X-Microsystems/xmicro-vdp/README.md

# XMICRO-VDP
Video card for the [XMICRO Bus](https://github.com/X-Microsystems/xmicro-bus), based on the Yamaha V9958 VDP

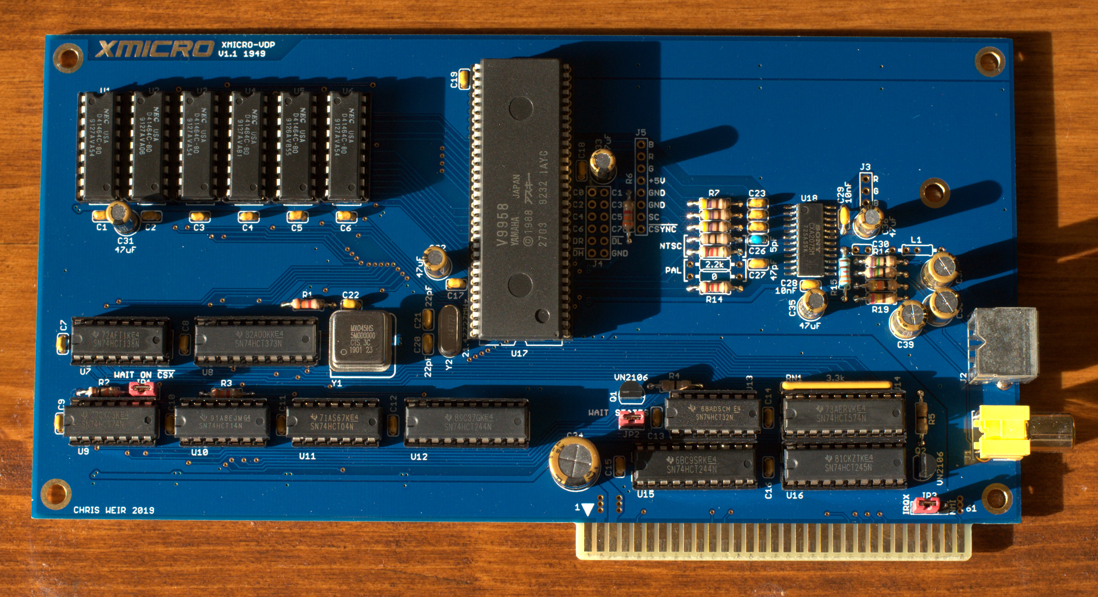
[picture p1: Images/XMICRO-VDP.jpg]
XMICRO-VDP


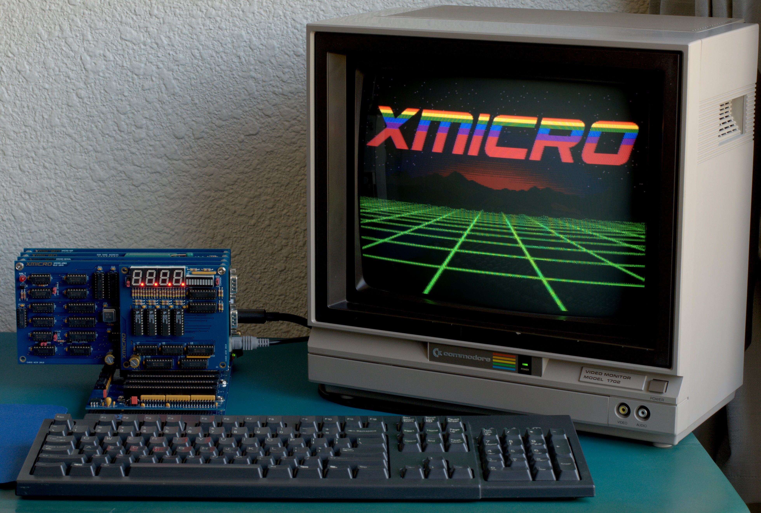
[picture p2: Images/System Running.jpg]
