X-Microsystems/xmicro-vdp/Documentation/Schematics/XMICRO-VDP V1.1 Netlist.txt

Netlist

Exported from XMICRO-VDP V1.1.sch at 12/8/2019 7:52:22 PM

EAGLE Version 6.3.0 Copyright (c) 1988-2012 CadSoft

Net      Part     Pad      Pin        Sheet

!BCSX    CE1      9        !CSX       1
         U15      2        A1         1

!BRD     CE1      21       !RD        1
         U15      15       A3         1

!BRST    CE1      14       !RST       1
         U10      1        I          1

!BWAIT   CE1      18       !WAIT      1
         JP2      2        2          4

!BWR     CE1      22       !WR        1
         U15      6        A3         1

!CSIDR   U12      1        G          5
         U12      19       G          5
         U7       9        Y6         2

!CSVR    U17      31       !CSR       2
         U7       13       Y2         2

!CSVW    U17      30       !CSW       2
         U7       14       Y1         2

!CSX     U11      11       I          4
         U13      13       I1         1
         U13      9        I0         1
         U15      18       Y1         1
         U7       4        G2A        2
         U8       11       ENC        2

!CSYNC   J5       8        8          3
         R14      1        1          3
         U17      6        !CSYNC     2

!DHCLK   J4       11       11         2
         U17      2        !DHCLK     2

!DLCLK   J4       10       10         2
         R6       1        1          2
         U17      3        !DLCLK     2

!RD      U13      12       I0         1
         U15      5        Y3         1
         U7       1        A          2

!RST     U10      4        O          1
         U17      9        !RESET     2
         U9       13       CLR        4

!VCAS0   U1       16       !CAS       2
         U17      61       !CAS0      2
         U4       16       !CAS       2

!VCAS1   U17      60       !CAS1      2
         U2       16       !CAS       2
         U5       16       !CAS       2

!VCAS2   U17      59       !CASX      2
         U3       16       !CAS       2
         U6       16       !CAS       2

!VINT    R1       1        1          1
         U10      9        I          1
         U17      25       !INT       2

!VRAS    U1       5        !RAS       2
         U17      62       !RAS       2
         U2       5        !RAS       2
         U3       5        !RAS       2
         U4       5        !RAS       2
         U5       5        !RAS       2
         U6       5        !RAS       2

!VWAIT   R3       1        1          4
         U10      13       I          4
         U17      26       !WAIT      2

!WR      U11      1        I          1
         U13      10       I1         1
         U15      14       Y3         1
         U7       2        B          2

A0       U15      7        Y2         1
         U8       3        1D         2

A1       U15      12       Y4         1
         U8       4        2D         2

A7       U15      9        Y1         1
         U7       3        C          2
         U8       7        3D         2

B        C25      P$1      1          3
         J5       1        1          3
         R9       2        2          3
         U17      24       B          2

BA0      CE1      23       A0         1
         U15      13       A2         1

BA1      CE1      24       A1         1
         U15      8        A4         1

BA7      CE1      30       A7         1
         U15      11       A1         1

C0       J4       1        1          2
         U17      19       C0         2

C1       J4       2        2          2
         U17      18       C1         2

C2       J4       3        3          2
         U17      17       C2         2

C3       J4       4        4          2
         U17      16       C3         2

C4       J4       5        5          2
         U17      15       C4         2

C5       J4       6        6          2
         U17      14       C5         2

C6       J4       7        7          2
         U17      13       C6         2

C7       J4       8        8          2
         U17      12       C7         2

CBDR     J4       9        9          2
         U17      11       CBDR       2

D0       RN1      2        2          1
         U12      18       Y1         5
         U14      19       1Q         1
         U16      18       B1         1
         U17      40       CD0        2

D1       RN1      3        3          1
         U12      3        Y4         5
         U14      18       2Q         1
         U16      17       B2         1
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

VR/!W    U1       4        !WE        2
         U17      57       R/!W       2
         U2       4        !WE        2
         U3       4        !WE        2
         U4       4        !WE        2
         U5       4        !WE        2
         U6       4        !WE        2
