X-Microsystems/xmicro-vdp/Documentation/Schematics/XMICRO-VDP V1.1 Black Large.pdf

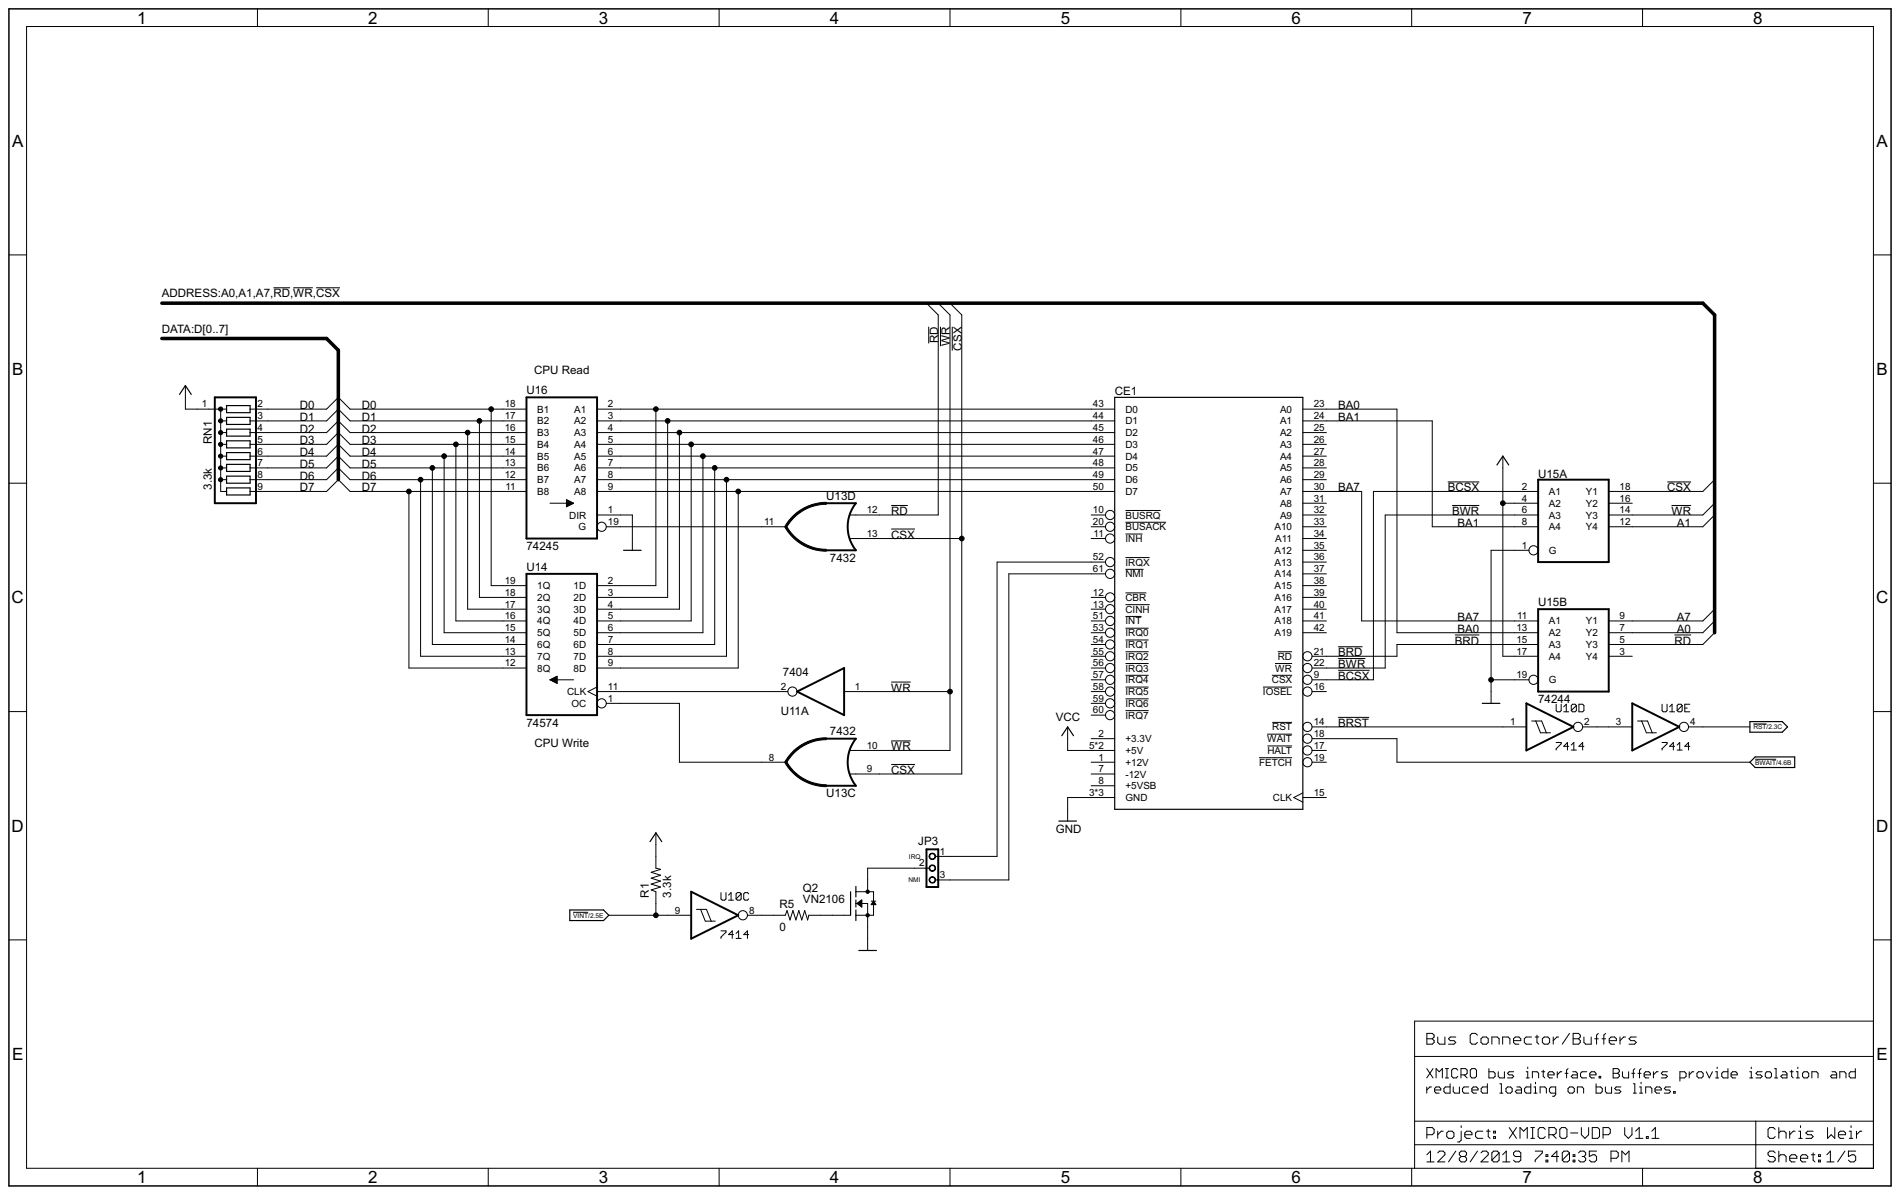
[picture p3: page 1]

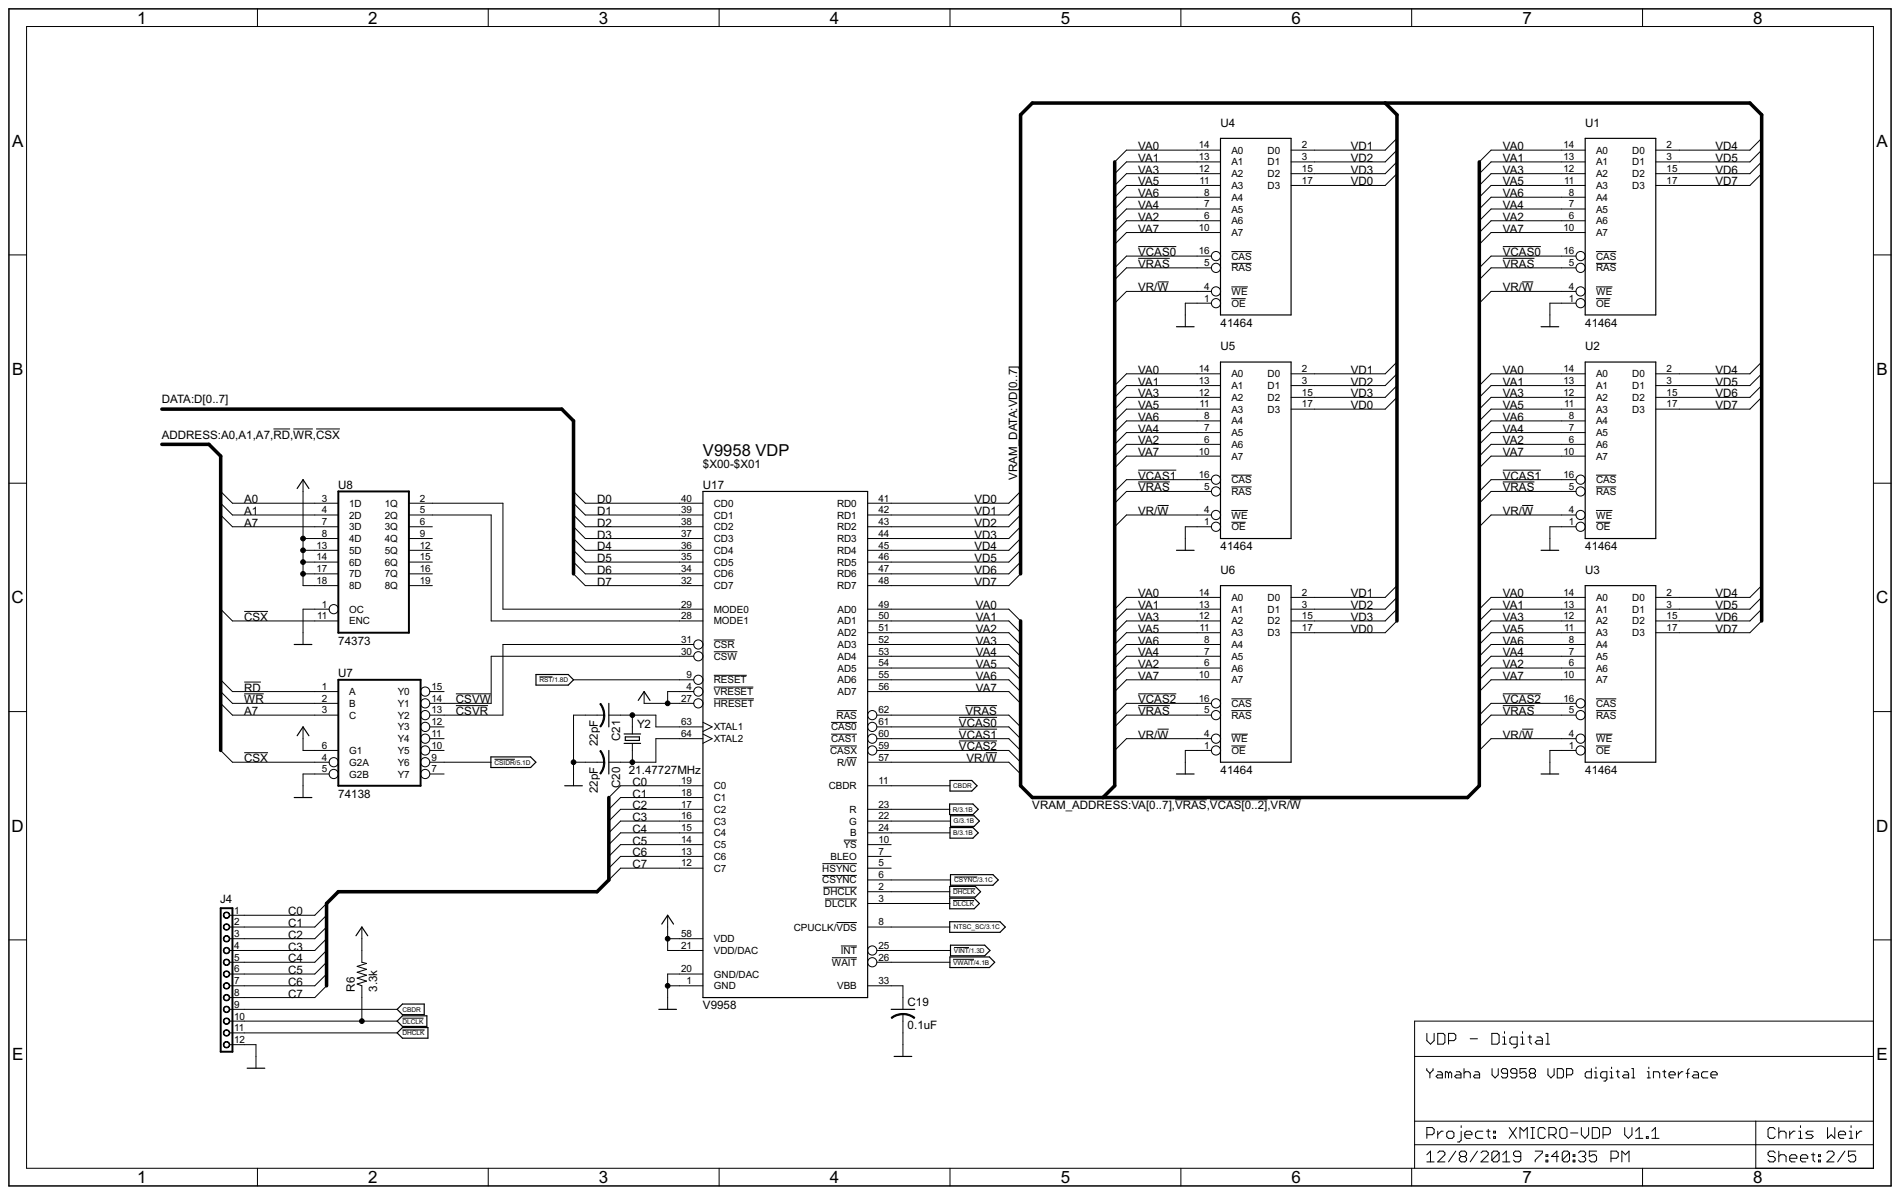
[picture p4: page 2]
