X-Microsystems/xmicro-vdp/Documentation/Schematics/XMICRO-VDP V1.1 Color Large.pdf

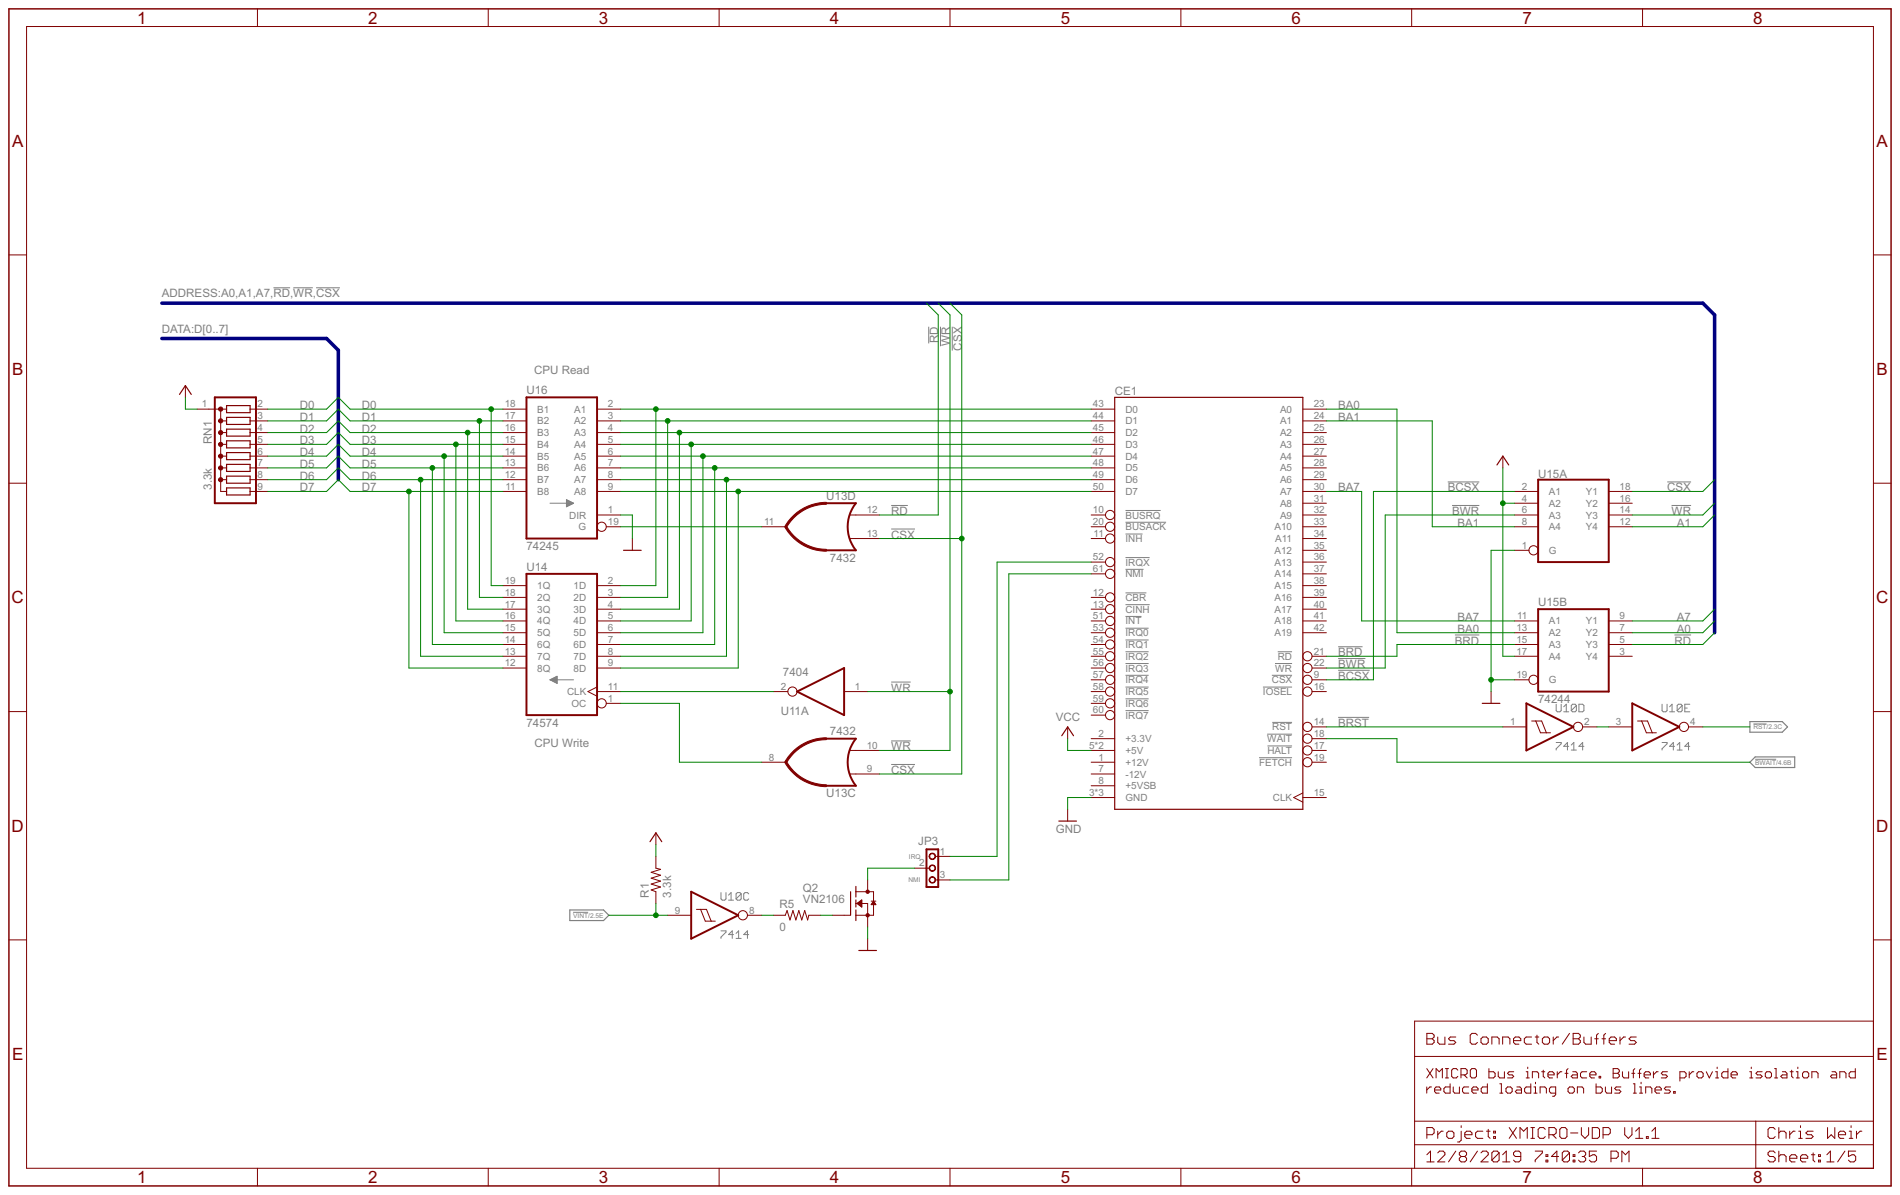
[picture p10: page 1]

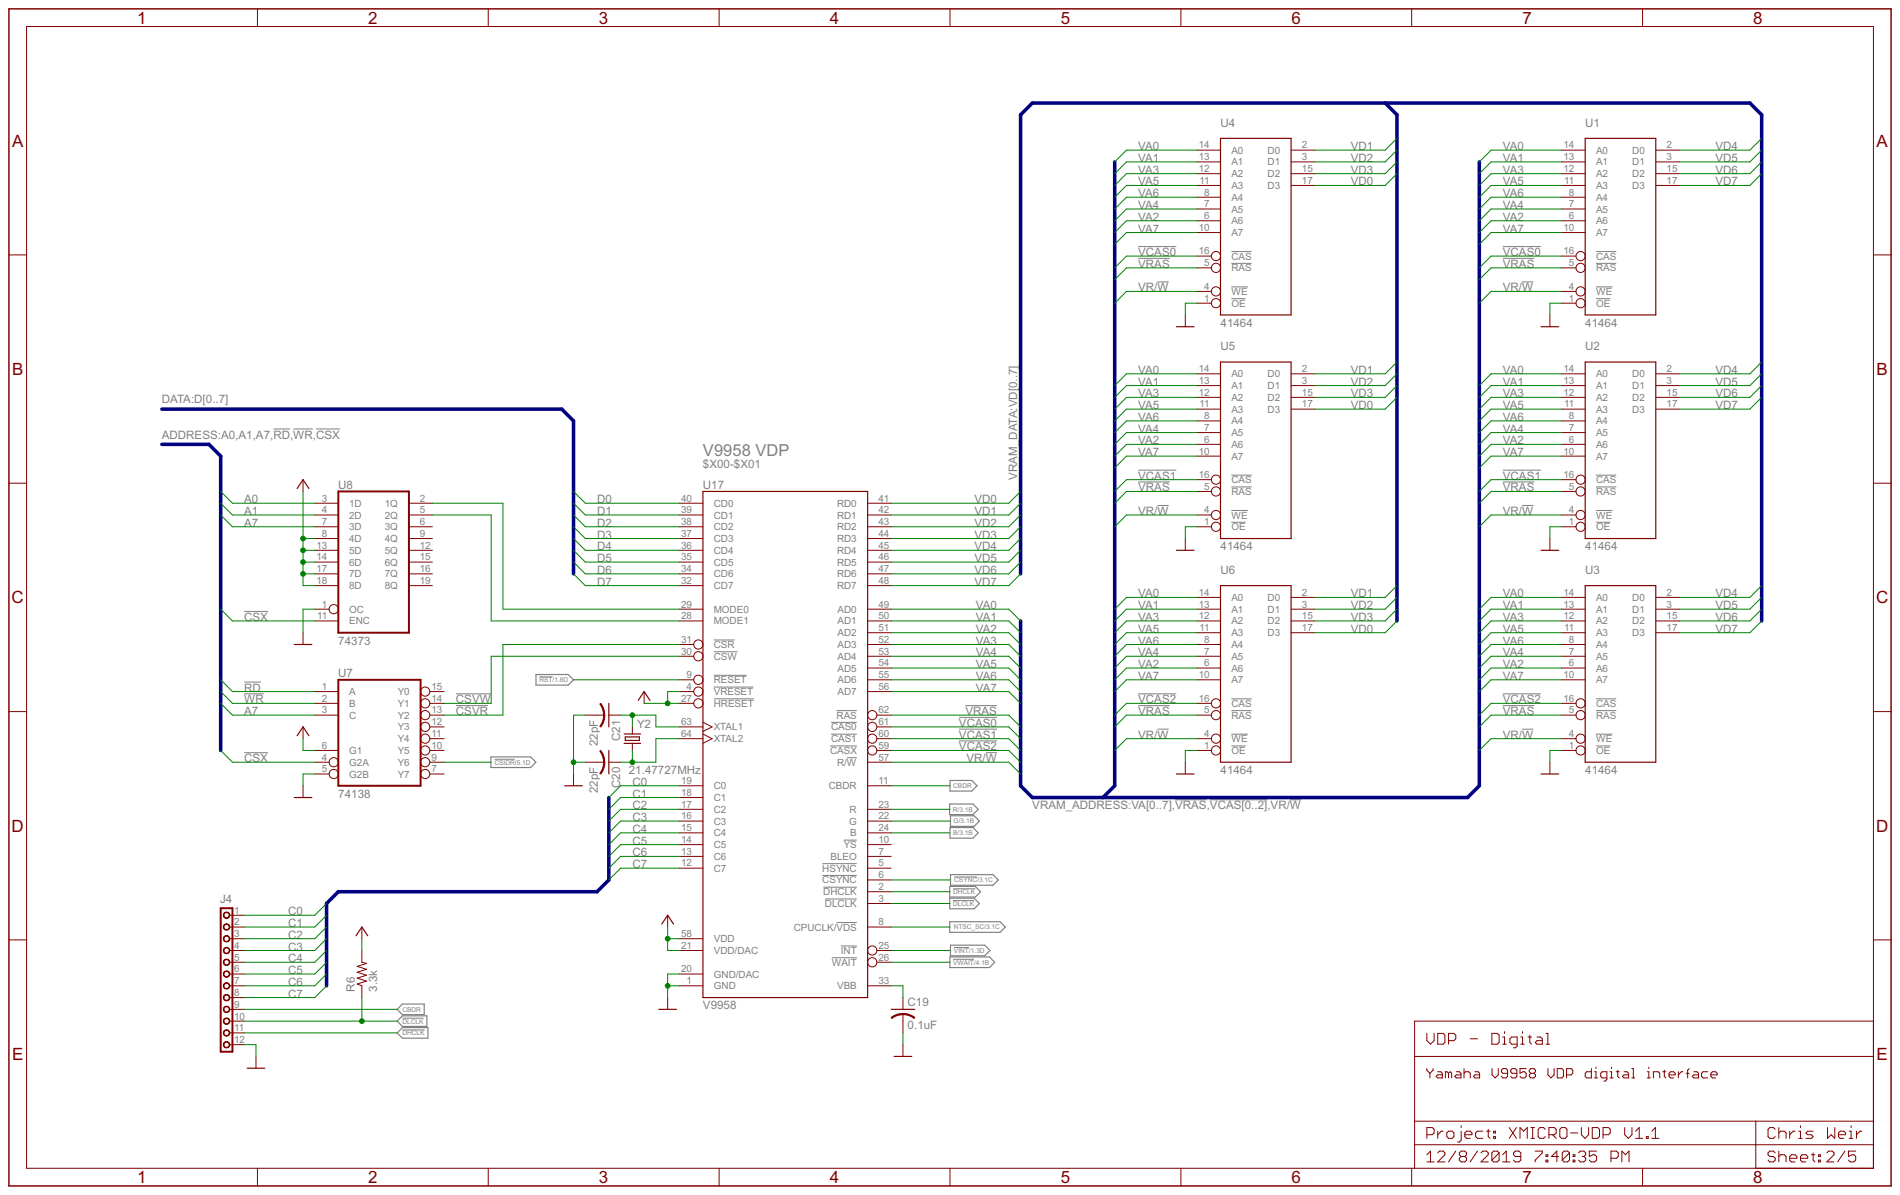
[picture p11: page 2]
