X-Microsystems/xmicro-vdp/Documentation/Schematics/XMICRO-VDP V1.1 Color.pdf

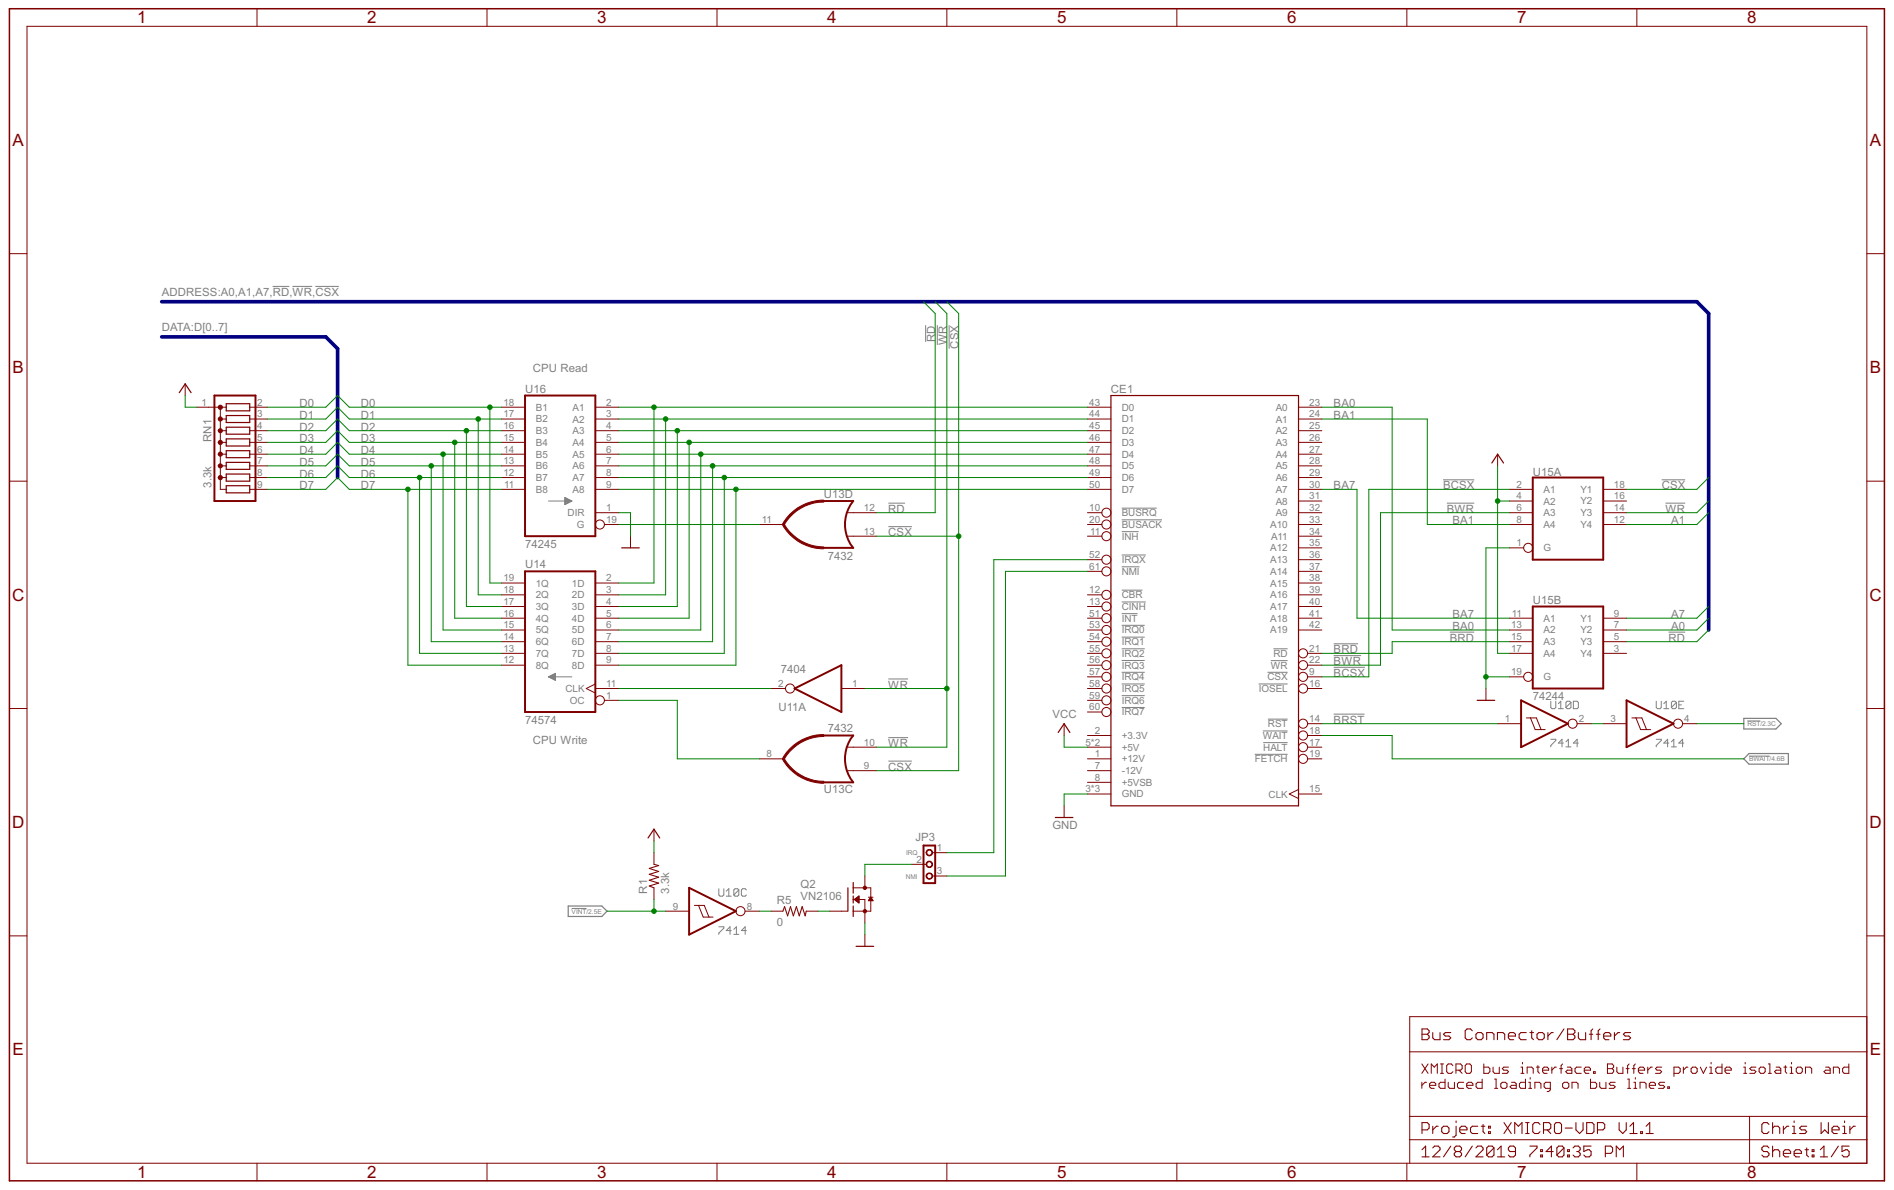
[picture p12: page 1]

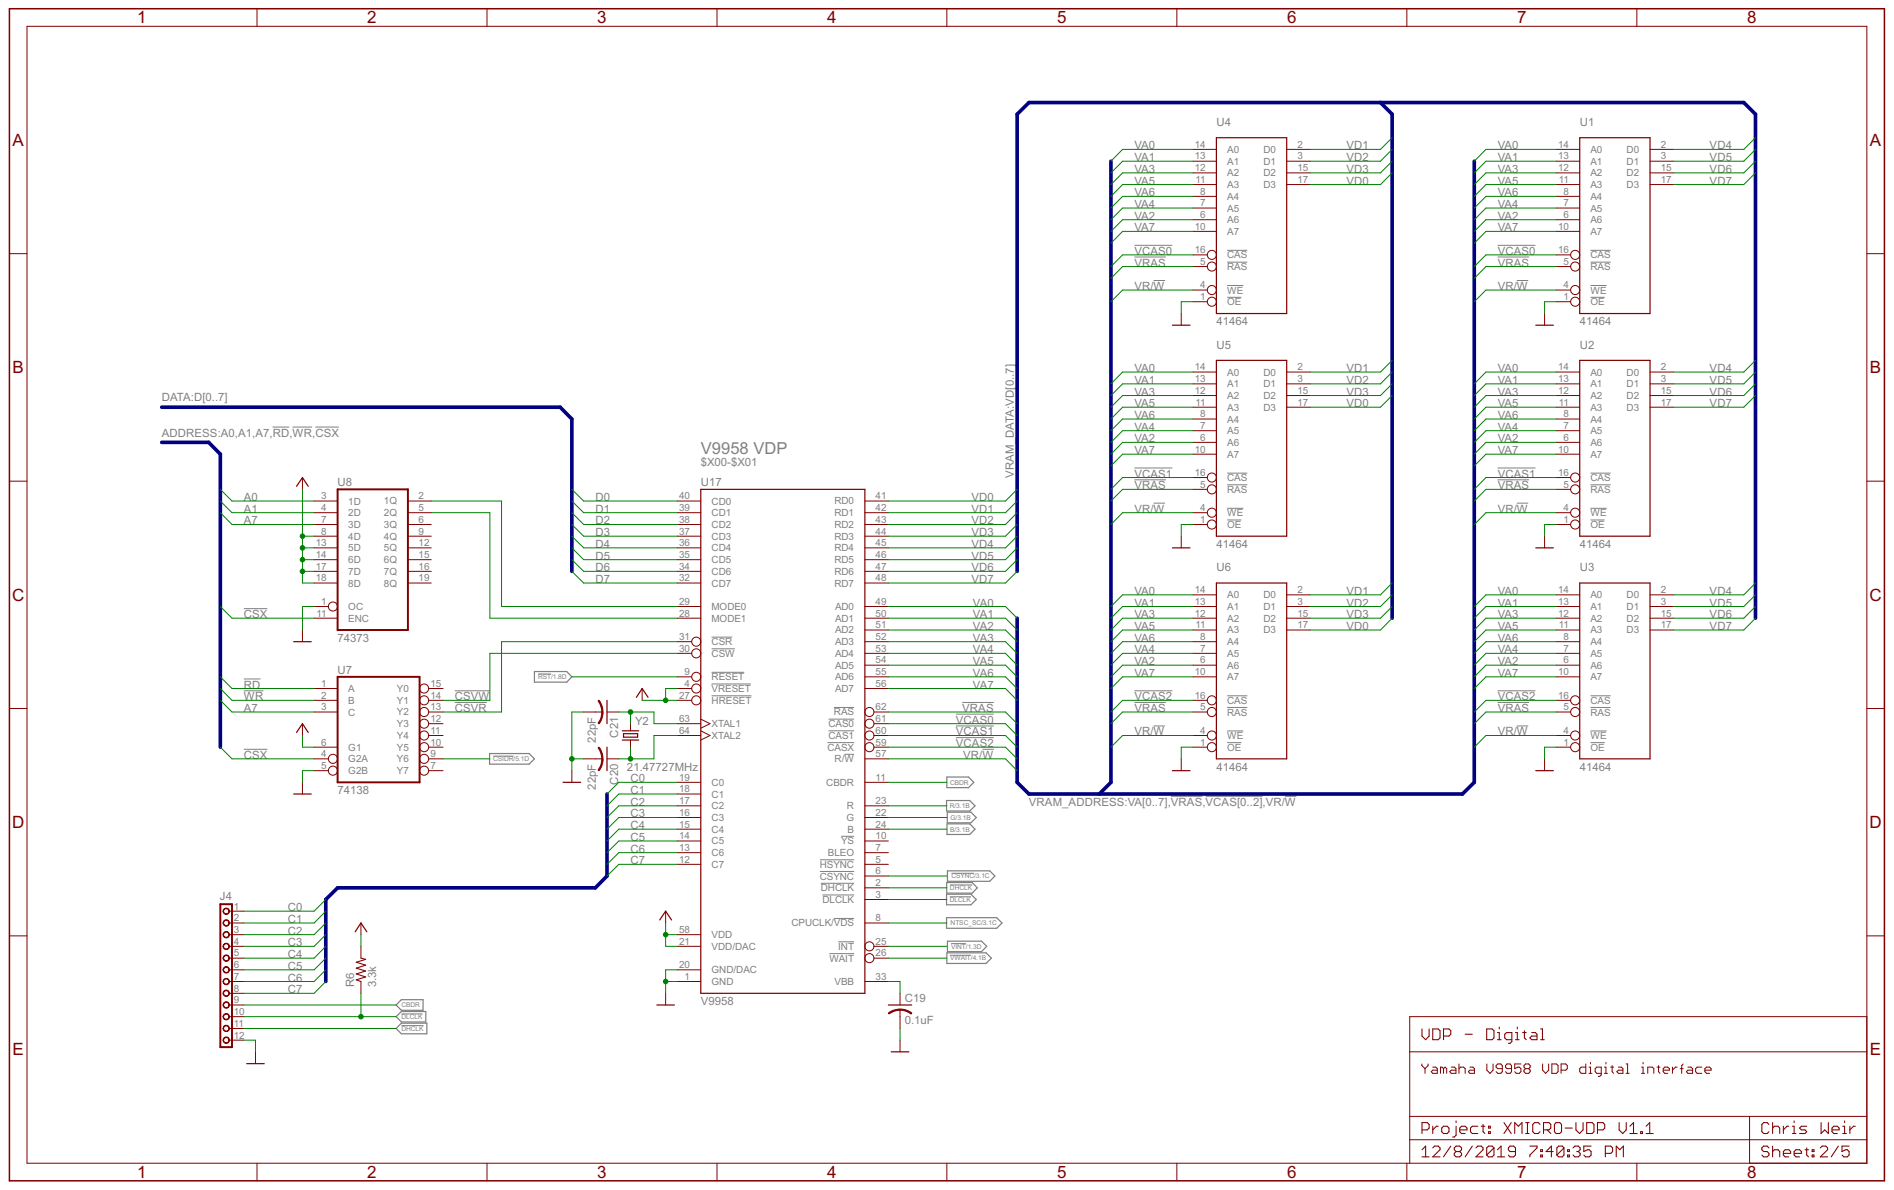
[picture p13: page 2]

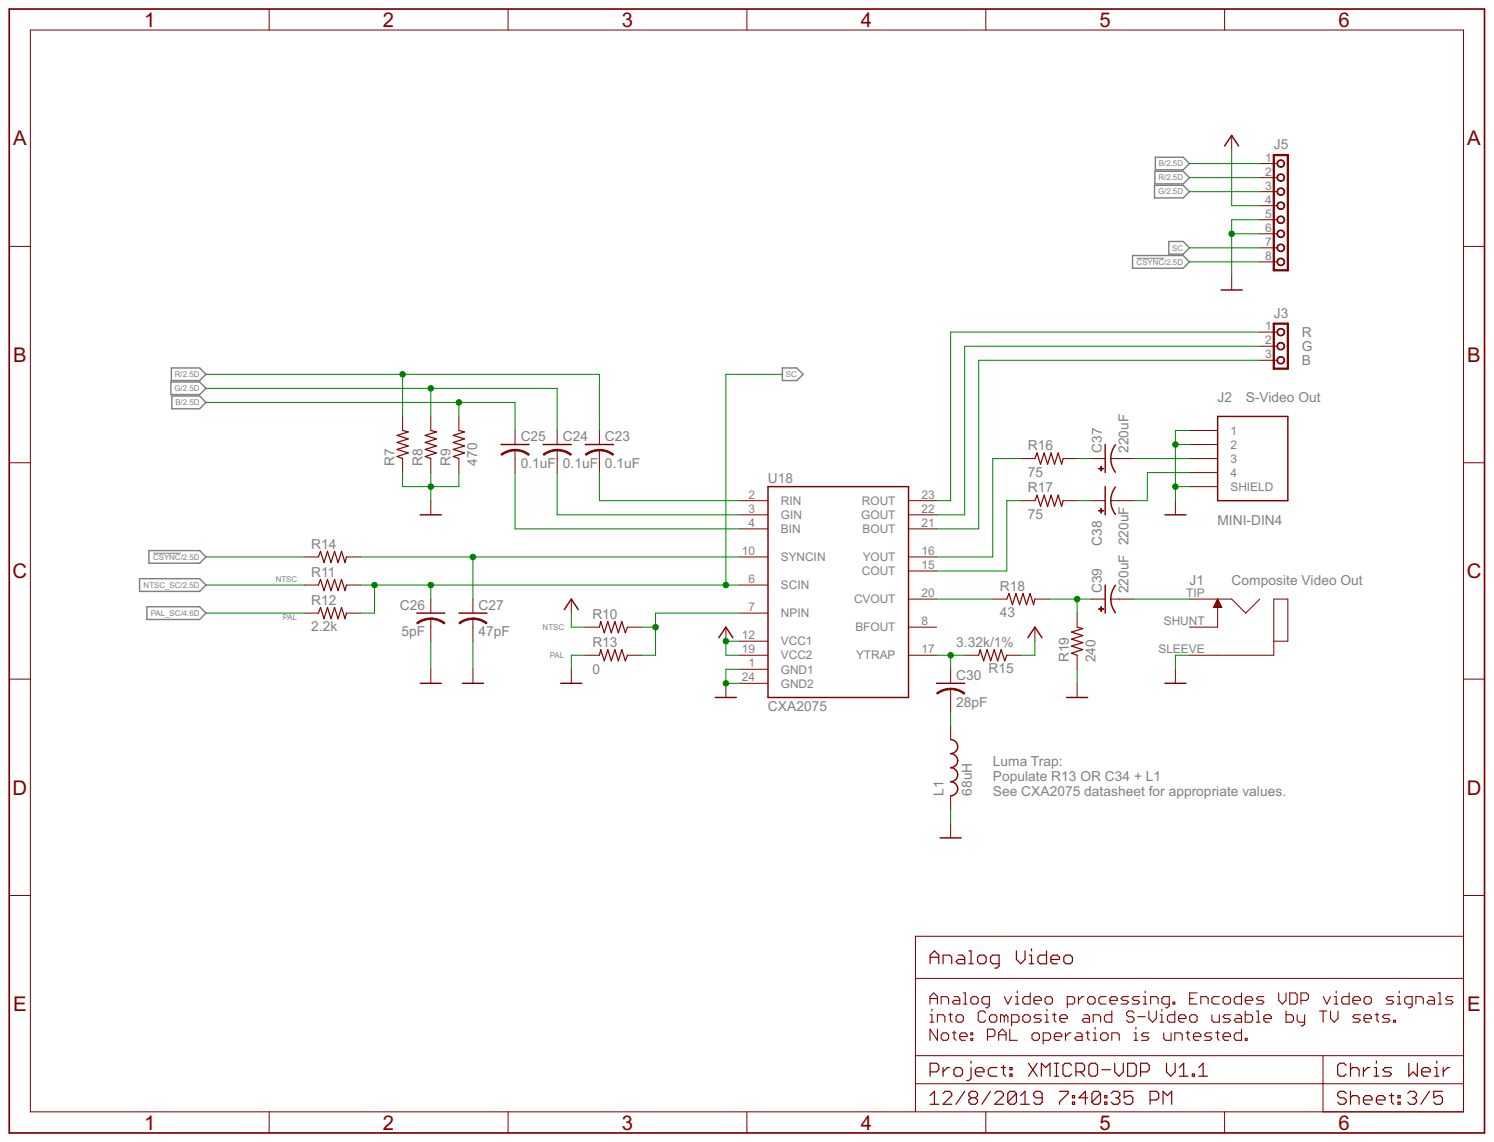
[picture p14: page 3]

See CXA2075 datasheet for appropriate values.

Luma Trap: Populate R13 OR C34 + L1

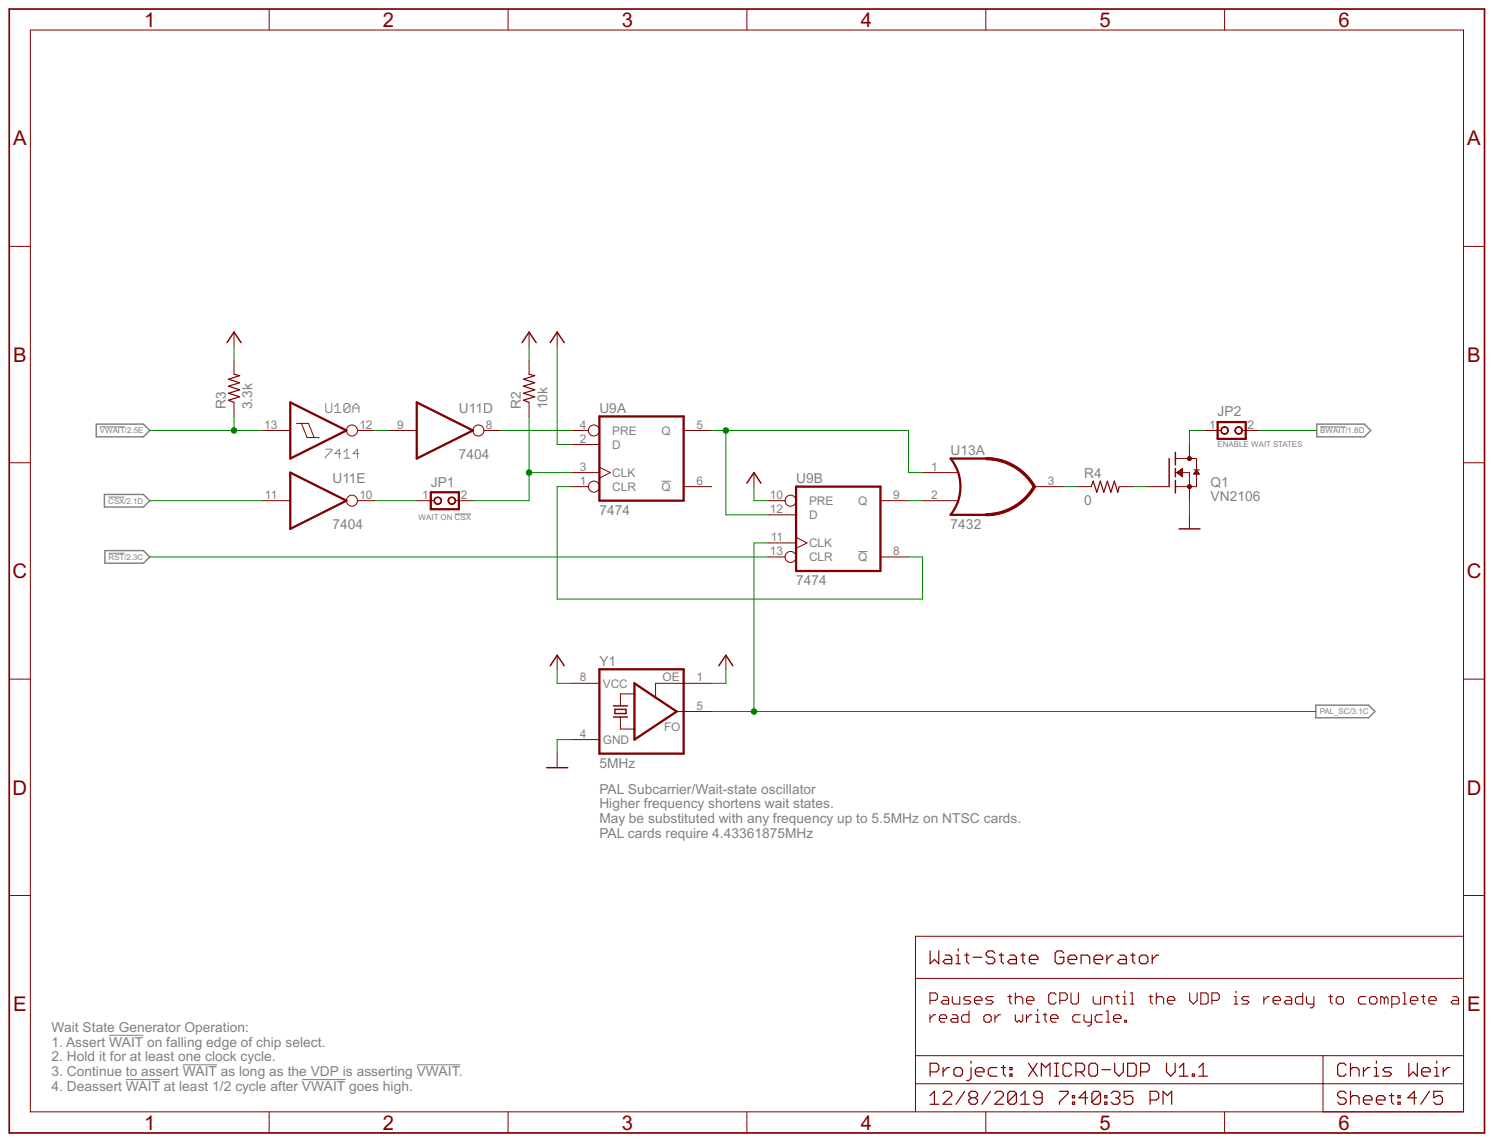
[picture p15: page 4]

ENABLE WAIT STATES WAIT ON CSX

PAL Subcarrier/Wait-state oscillator Higher frequency shortens wait states. May be substituted with any frequency up to 5.5MHz on NTSC cards. PAL cards require 4.43361875MHz

Wait State Generator Operation: 1. Assert WAIT on falling edge of chip select. 2. Hold it for at least one clock cycle. 3. Continue to assert WAIT as long as the VDP is asserting VWAIT. 4. Deassert WAIT at least 1/2 cycle after VWAIT goes high.

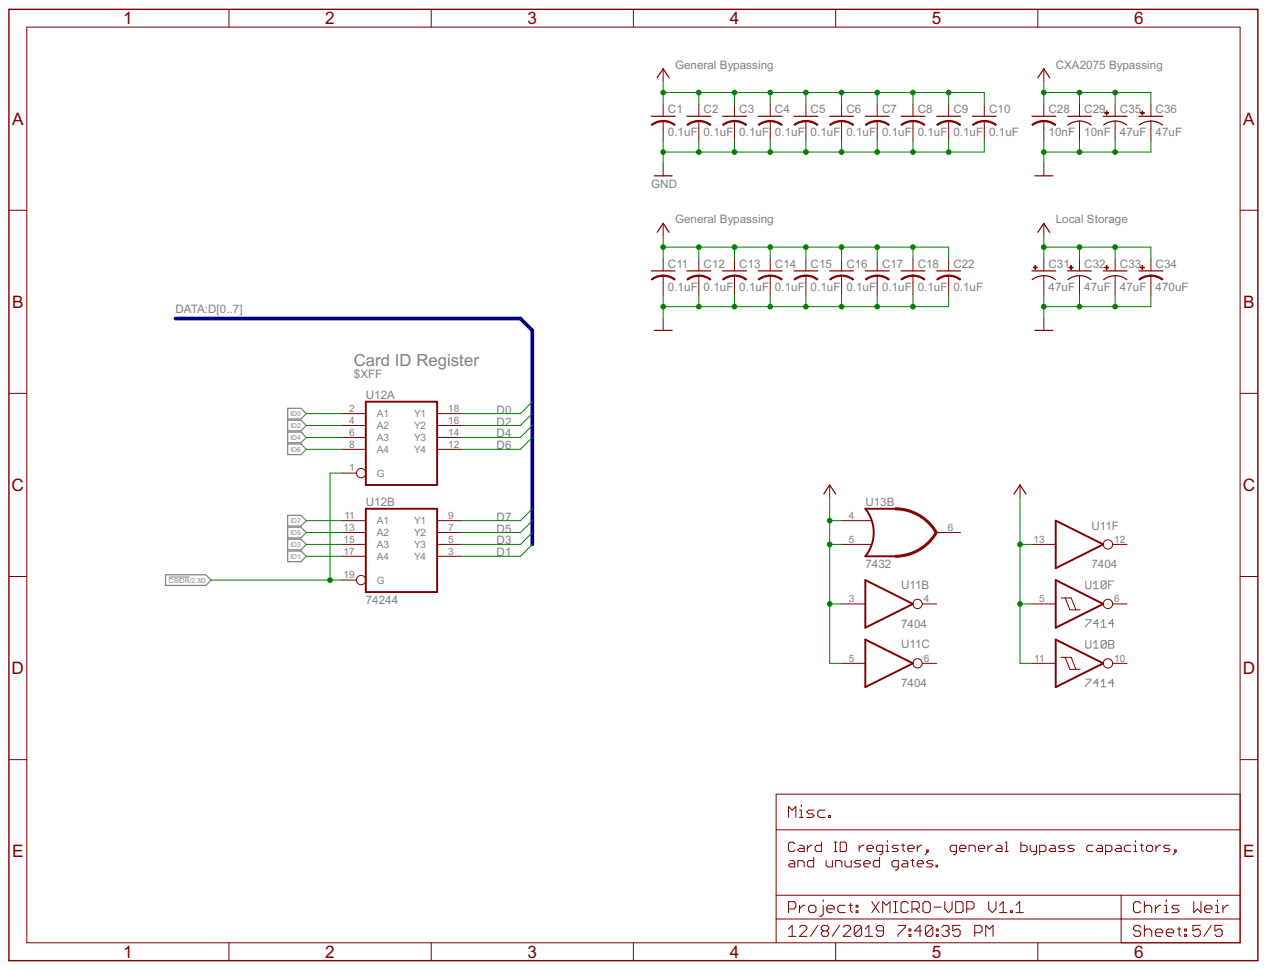
[picture p16: page 5]
