X-Microsystems/xmicro-vdp/Hardware/CAD/XMICRO-VDP V1.1.brd

## EAGLE design Hardware/CAD/XMICRO-VDP V1.1.brd (2019-12-09)

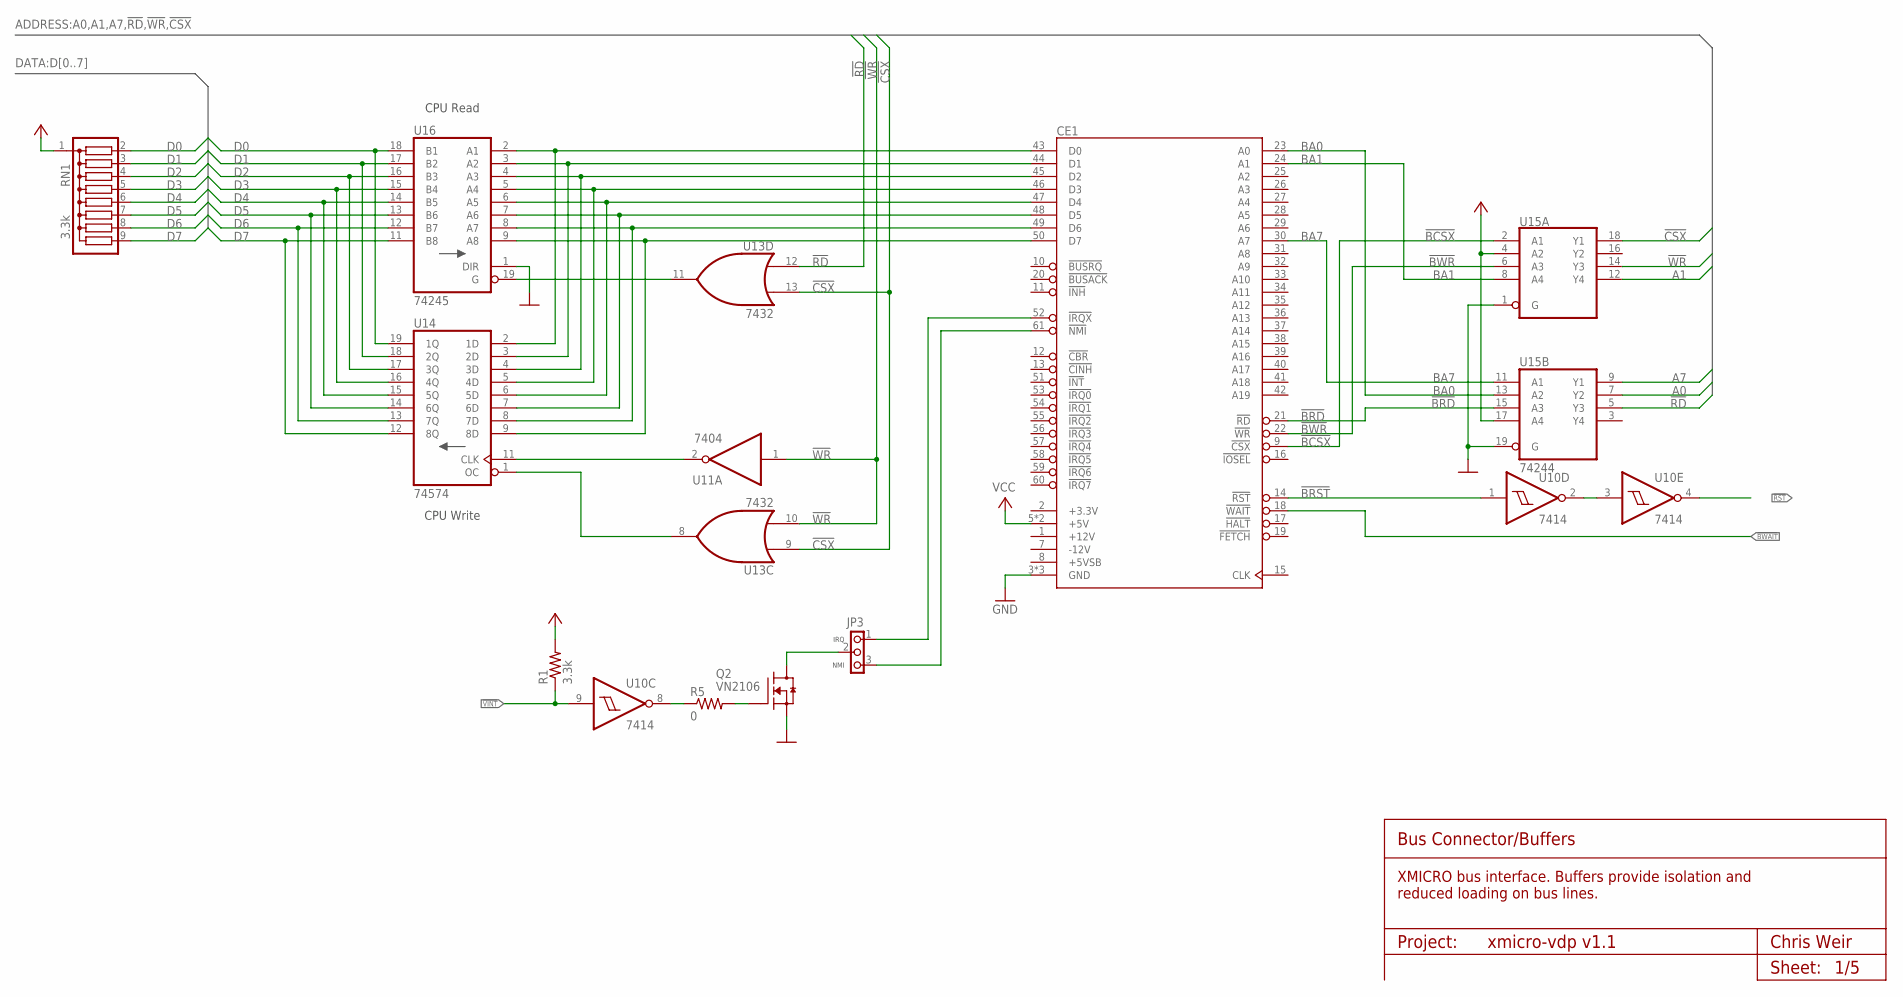
[picture p17: schematic XMICRO-VDP V1.1.sch, sheet 1, Bus Connections/Buffers]

Parts:
CE1: XMICRO-BUS-EDGE62M; EDGE62M
JP3: PINHD1X3THRU; 1X03
Q2: VN2106; TO92
R1: 3.3k; 0207/10
R5: 0; 0207/10
RN1: 3.3k; SIL9
U10: 7414; DIL14
U11: 7404; DIL14
U13: 7432; DIL14
U14: 74574; DIL20
U15: 74244; DIL20
U16: 74245; DIL20

Connections:
!BCSX: CE1.9 (!CSX), U15.2 (A1)
!BRD: CE1.21 (!RD), U15.15 (A3)
!BRST: CE1.14 (!RST), U10.1 (I)
!BWAIT: CE1.18 (!WAIT); also elsewhere on the board
!BWR: CE1.22 (!WR), U15.6 (A3)
!CSX: U13.9 (I0), U13.13 (I1), U15.18 (Y1); also elsewhere on the board
!RD: U13.12 (I0), U15.5 (Y3); also elsewhere on the board
!RST: U10.4 (O); also elsewhere on the board
!VINT: R1.1, U10.9 (I); also elsewhere on the board
!WR: U11.1 (I), U13.10 (I1), U15.14 (Y3); also elsewhere on the board
A0: U15.7 (Y2); also elsewhere on the board
A1: U15.12 (Y4); also elsewhere on the board
A7: U15.9 (Y1); also elsewhere on the board
BA0: CE1.23 (A0), U15.13 (A2)
BA1: CE1.24 (A1), U15.8 (A4)
BA7: CE1.30 (A7), U15.11 (A1)
D0: RN1.2, U14.19 (1Q), U16.18 (B1); also elsewhere on the board
D1: RN1.3, U14.18 (2Q), U16.17 (B2); also elsewhere on the board
D2: RN1.4, U14.17 (3Q), U16.16 (B3); also elsewhere on the board
D3: RN1.5, U14.16 (4Q), U16.15 (B4); also elsewhere on the board
D4: RN1.6, U14.15 (5Q), U16.14 (B5); also elsewhere on the board
D5: RN1.7, U14.14 (6Q), U16.13 (B6); also elsewhere on the board
D6: RN1.8, U14.13 (7Q), U16.12 (B7); also elsewhere on the board
D7: RN1.9, U14.12 (8Q), U16.11 (B8); also elsewhere on the board
GND: CE1.3 (GND), CE1.4 (GND), CE1.62 (GND), Q2.1 (S), U10.7 (GND), U11.7 (GND), U13.7 (GND), U14.10 (GND), U15.1 (G), U15.10 (GND), U15.19 (G), U16.1 (DIR), U16.10 (GND); also elsewhere on the board
unnamed: Q2.2 (G), R5.2
unnamed: JP3.2, Q2.3 (D)
unnamed: R5.1, U10.8 (O)
unnamed: U10.2 (O), U10.3 (I)
unnamed: CE1.50 (D7), U14.9 (8D), U16.9 (A8)
unnamed: CE1.49 (D6), U14.8 (7D), U16.8 (A7)
unnamed: CE1.48 (D5), U14.7 (6D), U16.7 (A6)
unnamed: CE1.47 (D4), U14.6 (5D), U16.6 (A5)
unnamed: CE1.46 (D3), U14.5 (4D), U16.5 (A4)
unnamed: CE1.45 (D2), U14.4 (3D), U16.4 (A3)
unnamed: CE1.44 (D1), U14.3 (2D), U16.3 (A2)
unnamed: CE1.43 (D0), U14.2 (1D), U16.2 (A1)
unnamed: U13.11 (O), U16.19 (G)
unnamed: U11.2 (O), U14.11 (CLK)
unnamed: U13.8 (O), U14.1 (OC)
unnamed: CE1.61 (!NMI), JP3.3
unnamed: CE1.52 (!IRQX), JP3.1
VCC: CE1.5 (+5V), CE1.6 (+5V), R1.2, RN1.1, U10.14 (VCC), U11.14 (VCC), U13.14 (VCC), U14.20 (VCC), U15.4 (A2), U15.17 (A4), U15.20 (VCC), U16.20 (VCC); also elsewhere on the board

Notes on the sheet:
CPU Read
CPU Write
IRQ
NMI
Project:
Chris Weir
Sheet:
Bus Connector/Buffers
XMICRO bus interface. Buffers provide isolation and reduced loading on bus lines.

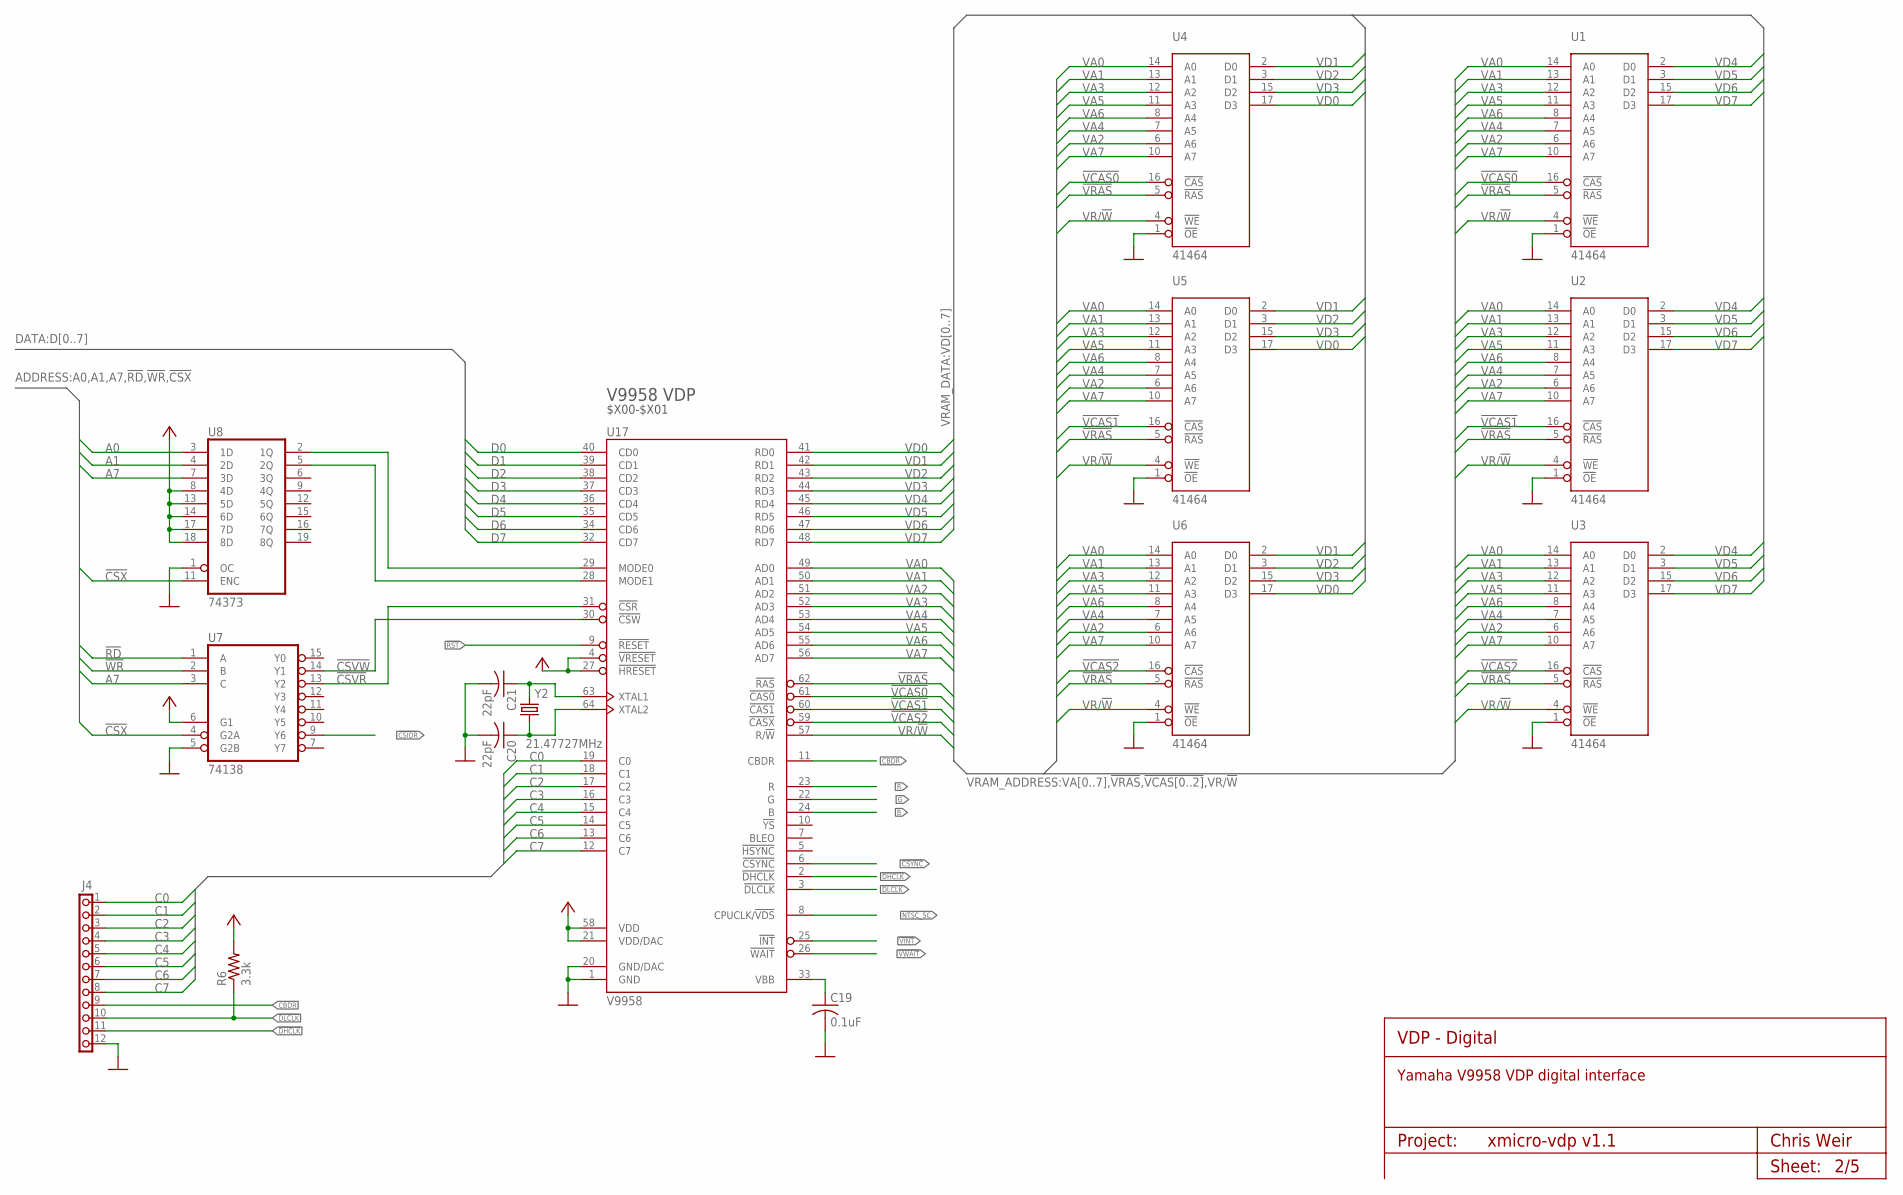
[picture p18: schematic XMICRO-VDP V1.1.sch, sheet 2, VDP - Digital]

Parts:
C19: 0.1uF; C100
C20, C21: 22pF; C100
J4: PINHD-2X6; 2X06
R6: 3.3k; 0207/10
U1, U2, U3, U4, U5, U6: 41464; DIL18
U7: 74138; DIL16
U8: 74373; DIL20
U17: V9958; SDIP64
Y2: 21.47727MHz; HC-49US

Connections:
!CSIDR: U7.9 (Y6); also elsewhere on the board
!CSVR: U7.13 (Y2), U17.31 (!CSR)
!CSVW: U7.14 (Y1), U17.30 (!CSW)
!CSX: U7.4 (G2A), U8.11 (ENC); also elsewhere on the board
!CSYNC: U17.6 (!CSYNC); also elsewhere on the board
!DHCLK: J4.11, U17.2 (!DHCLK)
!DLCLK: J4.10, R6.1, U17.3 (!DLCLK)
!RD: U7.1 (A); also elsewhere on the board
!RST: U17.9 (!RESET); also elsewhere on the board
!VCAS0: U1.16 (!CAS), U4.16 (!CAS), U17.61 (!CAS0)
!VCAS1: U2.16 (!CAS), U5.16 (!CAS), U17.60 (!CAS1)
!VCAS2: U3.16 (!CAS), U6.16 (!CAS), U17.59 (!CASX)
!VINT: U17.25 (!INT); also elsewhere on the board
!VRAS: U1.5 (!RAS), U2.5 (!RAS), U3.5 (!RAS), U4.5 (!RAS), U5.5 (!RAS), U6.5 (!RAS), U17.62 (!RAS)
!VWAIT: U17.26 (!WAIT); also elsewhere on the board
!WR: U7.2 (B); also elsewhere on the board
A0: U8.3 (1D); also elsewhere on the board
A1: U8.4 (2D); also elsewhere on the board
A7: U7.3 (C), U8.7 (3D); also elsewhere on the board
B: U17.24 (B); also elsewhere on the board
C0: J4.1, U17.19 (C0)
C1: J4.2, U17.18 (C1)
C2: J4.3, U17.17 (C2)
C3: J4.4, U17.16 (C3)
C4: J4.5, U17.15 (C4)
C5: J4.6, U17.14 (C5)
C6: J4.7, U17.13 (C6)
C7: J4.8, U17.12 (C7)
CBDR: J4.9, U17.11 (CBDR)
D0: U17.40 (CD0); also elsewhere on the board
D1: U17.39 (CD1); also elsewhere on the board
D2: U17.38 (CD2); also elsewhere on the board
D3: U17.37 (CD3); also elsewhere on the board
D4: U17.36 (CD4); also elsewhere on the board
D5: U17.35 (CD5); also elsewhere on the board
D6: U17.34 (CD6); also elsewhere on the board
D7: U17.32 (CD7); also elsewhere on the board
G: U17.22 (G); also elsewhere on the board
GND: C19.P$2 (2), C20.P$2 (2), C21.P$2 (2), J4.12, U1.1 (!OE), U1.18 (GND), U2.1 (!OE), U2.18 (GND), U3.1 (!OE), U3.18 (GND), U4.1 (!OE), U4.18 (GND), U5.1 (!OE), U5.18 (GND), U6.1 (!OE), U6.18 (GND), U7.5 (G2B), U7.8 (GND), U8.1 (OC), U8.10 (GND), U17.1 (GND), U17.20 (GND/DAC); also elsewhere on the board
unnamed: C21.P$1 (1), U17.63 (XTAL1), Y2.2
unnamed: C20.P$1 (1), U17.64 (XTAL2), Y2.1
unnamed: U8.2 (1Q), U17.29 (MODE0)
unnamed: C19.P$1 (1), U17.33 (VBB)
unnamed: U8.5 (2Q), U17.28 (MODE1)
NTSC_SC: U17.8 (CPUCLK/!VDS); also elsewhere on the board
R: U17.23 (R); also elsewhere on the board
VA0: U1.14 (A0), U2.14 (A0), U3.14 (A0), U4.14 (A0), U5.14 (A0), U6.14 (A0), U17.49 (AD0)
VA1: U1.13 (A1), U2.13 (A1), U3.13 (A1), U4.13 (A1), U5.13 (A1), U6.13 (A1), U17.50 (AD1)
VA2: U1.6 (A6), U2.6 (A6), U3.6 (A6), U4.6 (A6), U5.6 (A6), U6.6 (A6), U17.51 (AD2)
VA3: U1.12 (A2), U2.12 (A2), U3.12 (A2), U4.12 (A2), U5.12 (A2), U6.12 (A2), U17.52 (AD3)
VA4: U1.7 (A5), U2.7 (A5), U3.7 (A5), U4.7 (A5), U5.7 (A5), U6.7 (A5), U17.53 (AD4)
VA5: U1.11 (A3), U2.11 (A3), U3.11 (A3), U4.11 (A3), U5.11 (A3), U6.11 (A3), U17.54 (AD5)
VA6: U1.8 (A4), U2.8 (A4), U3.8 (A4), U4.8 (A4), U5.8 (A4), U6.8 (A4), U17.55 (AD6)
VA7: U1.10 (A7), U2.10 (A7), U3.10 (A7), U4.10 (A7), U5.10 (A7), U6.10 (A7), U17.56 (AD7)
VCC: R6.2, U1.9 (VCC), U2.9 (VCC), U3.9 (VCC), U4.9 (VCC), U5.9 (VCC), U6.9 (VCC), U7.6 (G1), U7.16 (VCC), U8.8 (4D), U8.13 (5D), U8.14 (6D), U8.17 (7D), U8.18 (8D), U8.20 (VCC), U17.4 (!VRESET), U17.21 (VDD/DAC), U17.27 (!HRESET), U17.58 (VDD); also elsewhere on the board
VD0: U4.17 (D3), U5.17 (D3), U6.17 (D3), U17.41 (RD0)
VD1: U4.2 (D0), U5.2 (D0), U6.2 (D0), U17.42 (RD1)
VD2: U4.3 (D1), U5.3 (D1), U6.3 (D1), U17.43 (RD2)
VD3: U4.15 (D2), U5.15 (D2), U6.15 (D2), U17.44 (RD3)
VD4: U1.2 (D0), U2.2 (D0), U3.2 (D0), U17.45 (RD4)
VD5: U1.3 (D1), U2.3 (D1), U3.3 (D1), U17.46 (RD5)
VD6: U1.15 (D2), U2.15 (D2), U3.15 (D2), U17.47 (RD6)
VD7: U1.17 (D3), U2.17 (D3), U3.17 (D3), U17.48 (RD7)
VR/!W: U1.4 (!WE), U2.4 (!WE), U3.4 (!WE), U4.4 (!WE), U5.4 (!WE), U6.4 (!WE), U17.57 (R/!W)

Notes on the sheet:
Project:
VDP - Digital
Chris Weir
Sheet:
Yamaha V9958 VDP digital interface
$X00-$X01
V9958 VDP

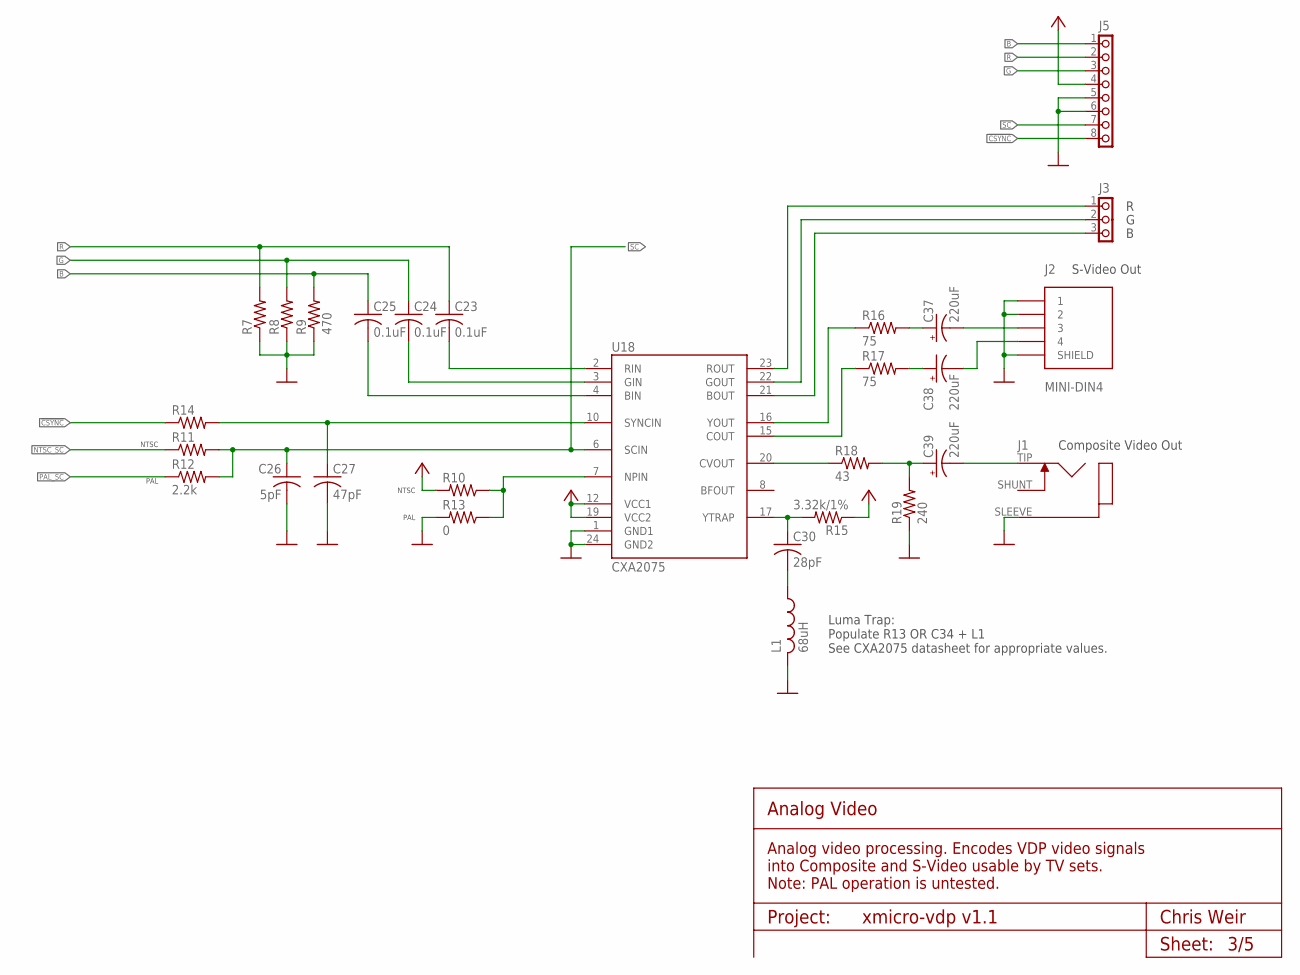
[picture p19: schematic XMICRO-VDP V1.1.sch, sheet 3, Analog Video]

Parts:
C23, C24, C25: 0.1uF; C100
C26: 5pF; C100
C27: 47pF; C100
C30: 28pF; C100
C37, C38, C39: 220uF; E2,5-7
J1: PJRAN1XU04AUX; PJRAN1
J2: MINI-DIN4
J3: PINHD1X3; 1X03
J5: PINHD-1X8; 1X08
L1: 68uH; 0207/10
R7, R8, R9: 470; 0207/10
R10, R13: 0; 0207/10
R11, R12, R14: 2.2k; 0207/10
R15: 3.32k/1%; 0207/10
R16, R17: 75; 0207/10
R18: 43; 0207/10
R19: 240; 0207/10
U18: CXA2075; SOP-24

Connections:
!CSYNC: J5.8, R14.1; also elsewhere on the board
B: C25.P$1 (1), J5.1, R9.2; also elsewhere on the board
G: C24.P$1 (1), J5.3, R8.2; also elsewhere on the board
GND: C26.P$2 (2), C27.P$2 (2), J1.SLEEVE, J2.1, J2.2, J2.G$1 (SHIELD), J2.G$2 (SHIELD), J2.G$3 (SHIELD), J5.5, J5.6, L1.2, R7.1, R8.1, R9.1, R13.2, R19.1, U18.1 (GND1), U18.24 (GND2); also elsewhere on the board
unnamed: J3.3, U18.21 (BOUT)
unnamed: C23.P$2 (2), U18.2 (RIN)
unnamed: C24.P$2 (2), U18.3 (GIN)
unnamed: C25.P$2 (2), U18.4 (BIN)
unnamed: J3.2, U18.22 (GOUT)
unnamed: J3.1, U18.23 (ROUT)
unnamed: R17.1, U18.15 (COUT)
unnamed: R16.1, U18.16 (YOUT)
unnamed: R18.1, U18.20 (CVOUT)
unnamed: C39.+, R18.2, R19.2
unnamed: C37.+, R16.2
unnamed: C38.+, R17.2
unnamed: C30.P$2 (2), L1.1
unnamed: C27.P$1 (1), R14.2, U18.10 (SYNCIN)
unnamed: R10.1, R13.1, U18.7 (NPIN)
unnamed: C38.-, J2.4
unnamed: C39.-, J1.TIP
unnamed: C30.P$1 (1), R15.2, U18.17 (YTRAP)
unnamed: C37.-, J2.3
NTSC_SC: R11.1; also elsewhere on the board
PAL_SC: R12.1; also elsewhere on the board
R: C23.P$1 (1), J5.2, R7.2; also elsewhere on the board
SC: C26.P$1 (1), J5.7, R11.2, R12.2, U18.6 (SCIN)
VCC: J5.4, R10.2, R15.1, U18.12 (VCC1), U18.19 (VCC2); also elsewhere on the board

Notes on the sheet:
NTSC
PAL
Composite Video Out
S-Video Out
Luma Trap: Populate R13 OR C34 + L1 See CXA2075 datasheet for appropriate values.
Project:
Analog Video
Chris Weir
Sheet:
Analog video processing. Encodes VDP video signals into Composite and S-Video usable by TV sets. Note: PAL operation is untested.

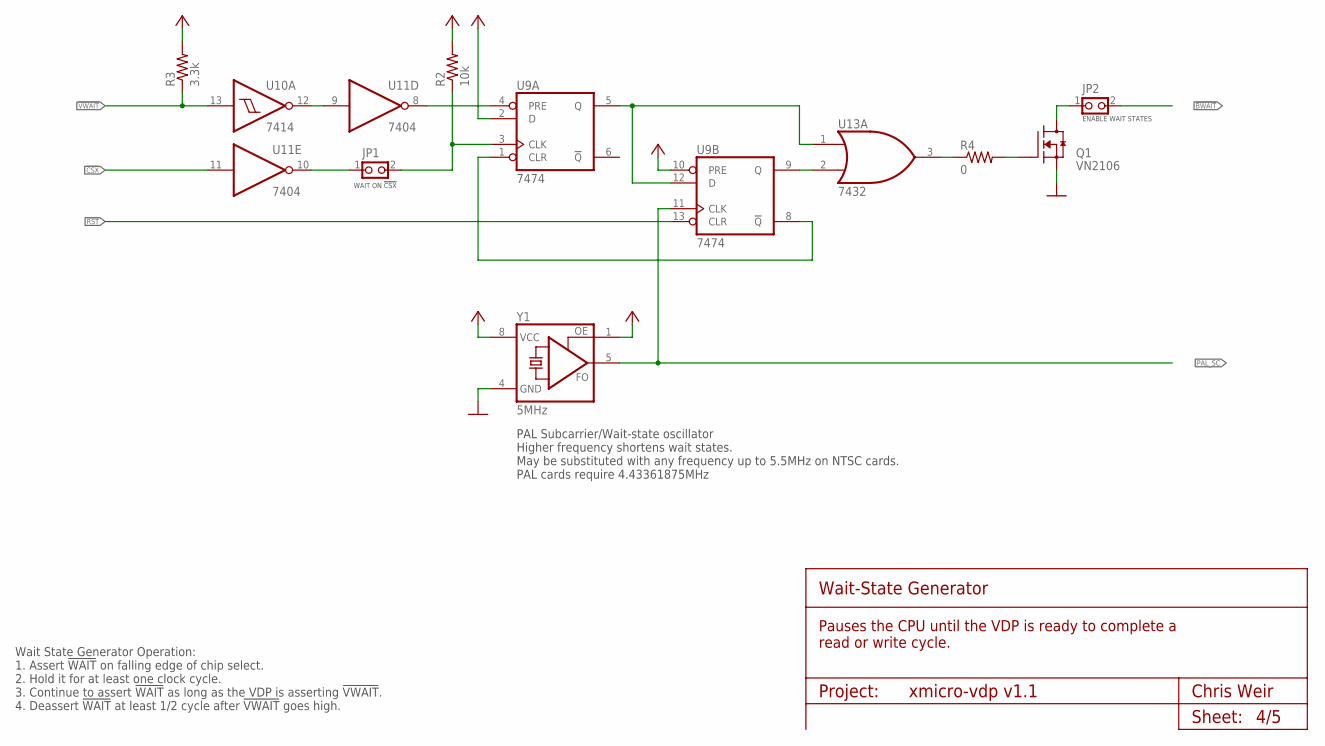
[picture p20: schematic XMICRO-VDP V1.1.sch, sheet 4, Wait-State Generator]

Parts:
JP1, JP2: PINHD-1X2THRU; 1X02
Q1: VN2106; TO92
R2: 10k; 0207/10
R3: 3.3k; 0207/10
R4: 0; 0207/10
U9: 7474; DIL14
U10: 7414; DIL14
U11: 7404; DIL14
U13: 7432; DIL14
Y1: 5MHz; DIL08S

Connections:
!BWAIT: JP2.2; also elsewhere on the board
!CSX: U11.11 (I); also elsewhere on the board
!RST: U9.13 (CLR); also elsewhere on the board
!VWAIT: R3.1, U10.13 (I); also elsewhere on the board
GND: Q1.1 (S), U9.7 (GND), U10.7 (GND), U11.7 (GND), U13.7 (GND), Y1.4 (GND); also elsewhere on the board
unnamed: U9.9 (Q), U13.2 (I1)
unnamed: JP2.1, Q1.3 (D)
unnamed: U9.4 (PRE), U11.8 (O)
unnamed: U10.12 (O), U11.9 (I)
unnamed: Q1.2 (G), R4.2
unnamed: JP1.1, U11.10 (O)
unnamed: R4.1, U13.3 (O)
unnamed: U9.5 (Q), U9.12 (D), U13.1 (I0)
unnamed: U9.1 (CLR), U9.8 (!Q)
unnamed: JP1.2, R2.1, U9.3 (CLK)
PAL_SC: U9.11 (CLK), Y1.5 (FO); also elsewhere on the board
VCC: R2.2, R3.2, U9.2 (D), U9.10 (PRE), U9.14 (VCC), U10.14 (VCC), U11.14 (VCC), U13.14 (VCC), Y1.1 (OE), Y1.8 (VCC); also elsewhere on the board

Notes on the sheet:
Wait State Generator Operation: 1. Assert !WAIT! on falling edge of chip select. 2. Hold it for at least one clock cycle. 3. Continue to assert !WAIT! as long as the VDP is asserting !VWAIT!. 4. Deassert !WAIT! at least 1/2 cycle after !VWAIT! goes high.
ENABLE WAIT STATES
WAIT ON !CSX!
PAL Subcarrier/Wait-state oscillator Higher frequency shortens wait states. May be substituted with any frequency up to 5.5MHz on NTSC cards. PAL cards require 4.43361875MHz
Project:
Wait-State Generator
Chris Weir
Sheet:
Pauses the CPU until the VDP is ready to complete a read or write cycle.

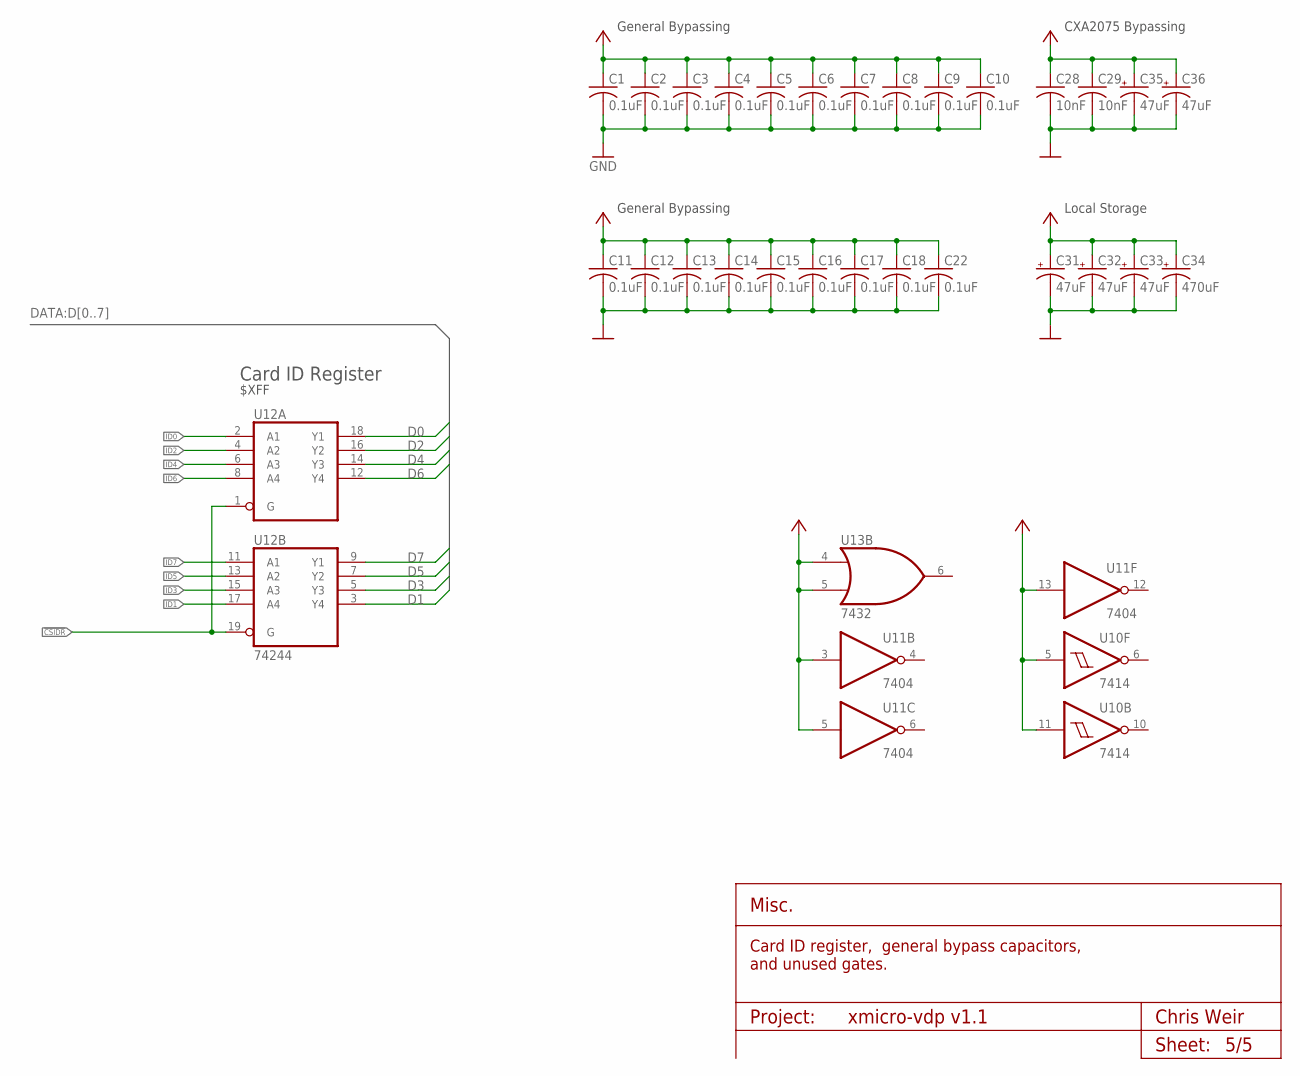
[picture p21: schematic XMICRO-VDP V1.1.sch, sheet 5, Misc.]

Parts:
C1, C2, C3, C4, C5, C6, C7, C8, C9, C10, C11, C12, C13, C14, C15, C16, C17, C18, C22: 0.1uF; C100
C28: 10nF; C100
C29: 10nF; C050-024X044
C31, C32, C33, C35, C36: 47uF; E2,5-6
C34: 470uF; C-10-5
U10: 7414; DIL14
U11: 7404; DIL14
U12: 74244; DIL20
U13: 7432; DIL14

Connections:
!CSIDR: U12.1 (G), U12.19 (G); also elsewhere on the board
D0: U12.18 (Y1); also elsewhere on the board
D1: U12.3 (Y4); also elsewhere on the board
D2: U12.16 (Y2); also elsewhere on the board
D3: U12.5 (Y3); also elsewhere on the board
D4: U12.14 (Y3); also elsewhere on the board
D5: U12.7 (Y2); also elsewhere on the board
D6: U12.12 (Y4); also elsewhere on the board
D7: U12.9 (Y1); also elsewhere on the board
GND: C1.P$2 (2), C2.P$2 (2), C3.P$2 (2), C4.P$2 (2), C5.P$2 (2), C6.P$2 (2), C7.P$2 (2), C8.P$2 (2), C9.P$2 (2), C10.P$2 (2), C11.P$2 (2), C12.P$2 (2), C13.P$2 (2), C14.P$2 (2), C15.P$2 (2), C16.P$2 (2), C17.P$2 (2), C18.P$2 (2), C22.P$2 (2), C28.P$2 (2), C29.2, C31.-, C32.-, C33.-, C34.-, C35.-, C36.-, U10.7 (GND), U11.7 (GND), U12.10 (GND), U13.7 (GND); also elsewhere on the board
ID0: U12.2 (A1)
ID1: U12.17 (A4)
ID2: U12.4 (A2)
ID3: U12.15 (A3)
ID4: U12.6 (A3)
ID5: U12.13 (A2)
ID6: U12.8 (A4)
ID7: U12.11 (A1)
VCC: C1.P$1 (1), C2.P$1 (1), C3.P$1 (1), C4.P$1 (1), C5.P$1 (1), C6.P$1 (1), C7.P$1 (1), C8.P$1 (1), C9.P$1 (1), C10.P$1 (1), C11.P$1 (1), C12.P$1 (1), C13.P$1 (1), C14.P$1 (1), C15.P$1 (1), C16.P$1 (1), C17.P$1 (1), C18.P$1 (1), C22.P$1 (1), C28.P$1 (1), C29.1, C31.+, C32.+, C33.+, C34.+, C35.+, C36.+, U10.5 (I), U10.11 (I), U10.14 (VCC), U11.3 (I), U11.5 (I), U11.13 (I), U11.14 (VCC), U12.20 (VCC), U13.4 (I0), U13.5 (I1), U13.14 (VCC); also elsewhere on the board

Notes on the sheet:
$XFF
Card ID Register
Project:
Misc.
Chris Weir
Sheet:
Card ID register, general bypass capacitors, and unused gates.
Local Storage
CXA2075 Bypassing
General Bypassing

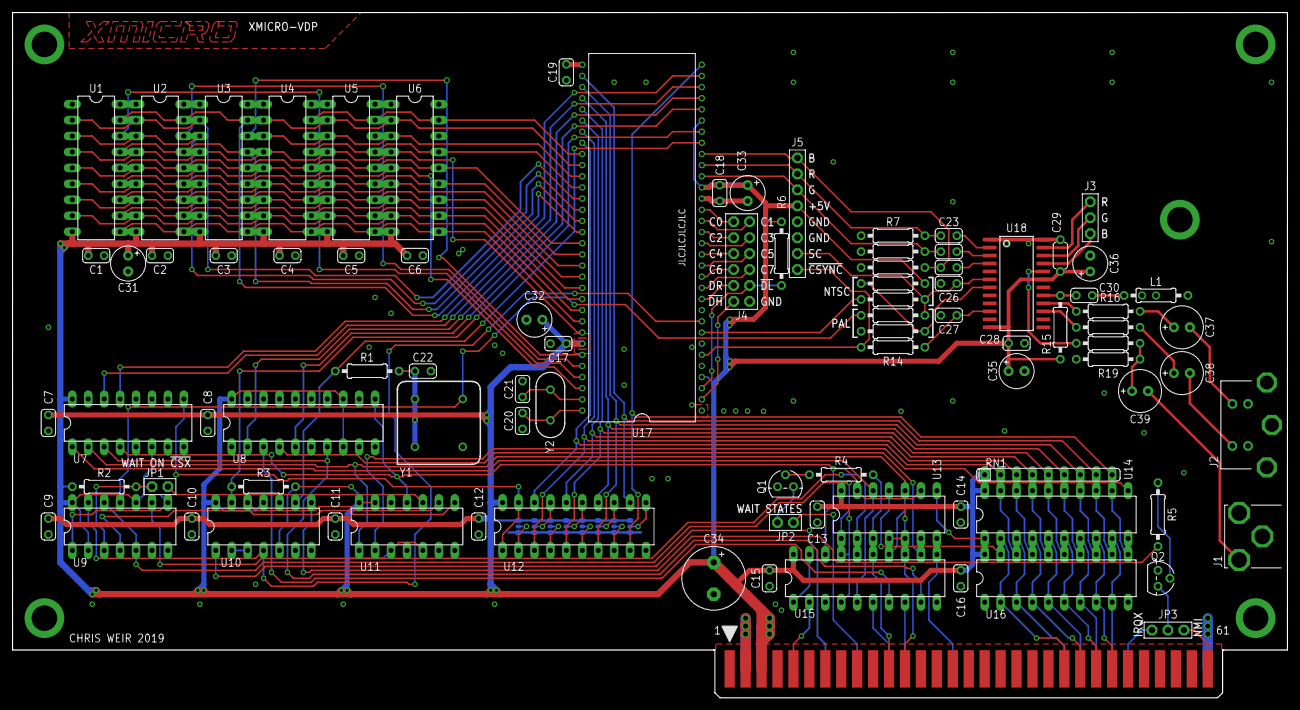
[picture p22: board XMICRO-VDP V1.1.brd from above]

Board: 2 copper layers, 203.2 x 109.2 mm, 91 parts (0 on the bottom side), 120 nets.
